essensys-hub/essensys-board-SC941C/docs/schematics.md

# 📐 Schéma Électronique Complet

Vous pouvez consulter ici l'intégralité du schéma électronique du module SC941C.

[📥 Télécharger le PDF complet](assets/SC941C_Schematic.pdf)

## Navigateur de Pages

### Page 1 : Sommaire / Page de Garde
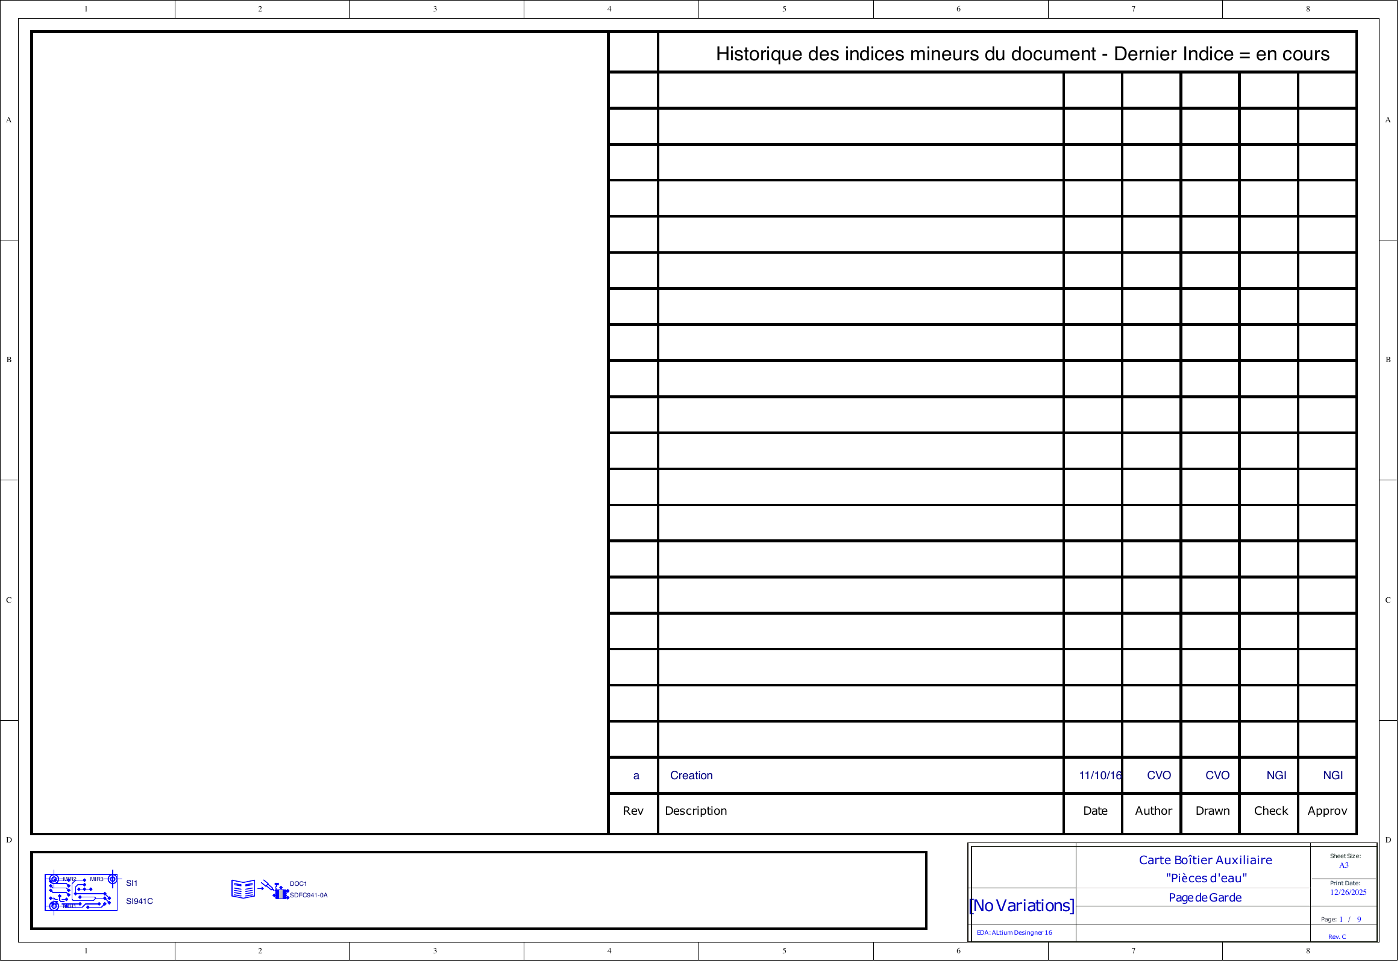
[picture p1: docs/assets/images/schematic_page-1.png]
Page 1


### Page 2 : Microcontrôleur (MCU)
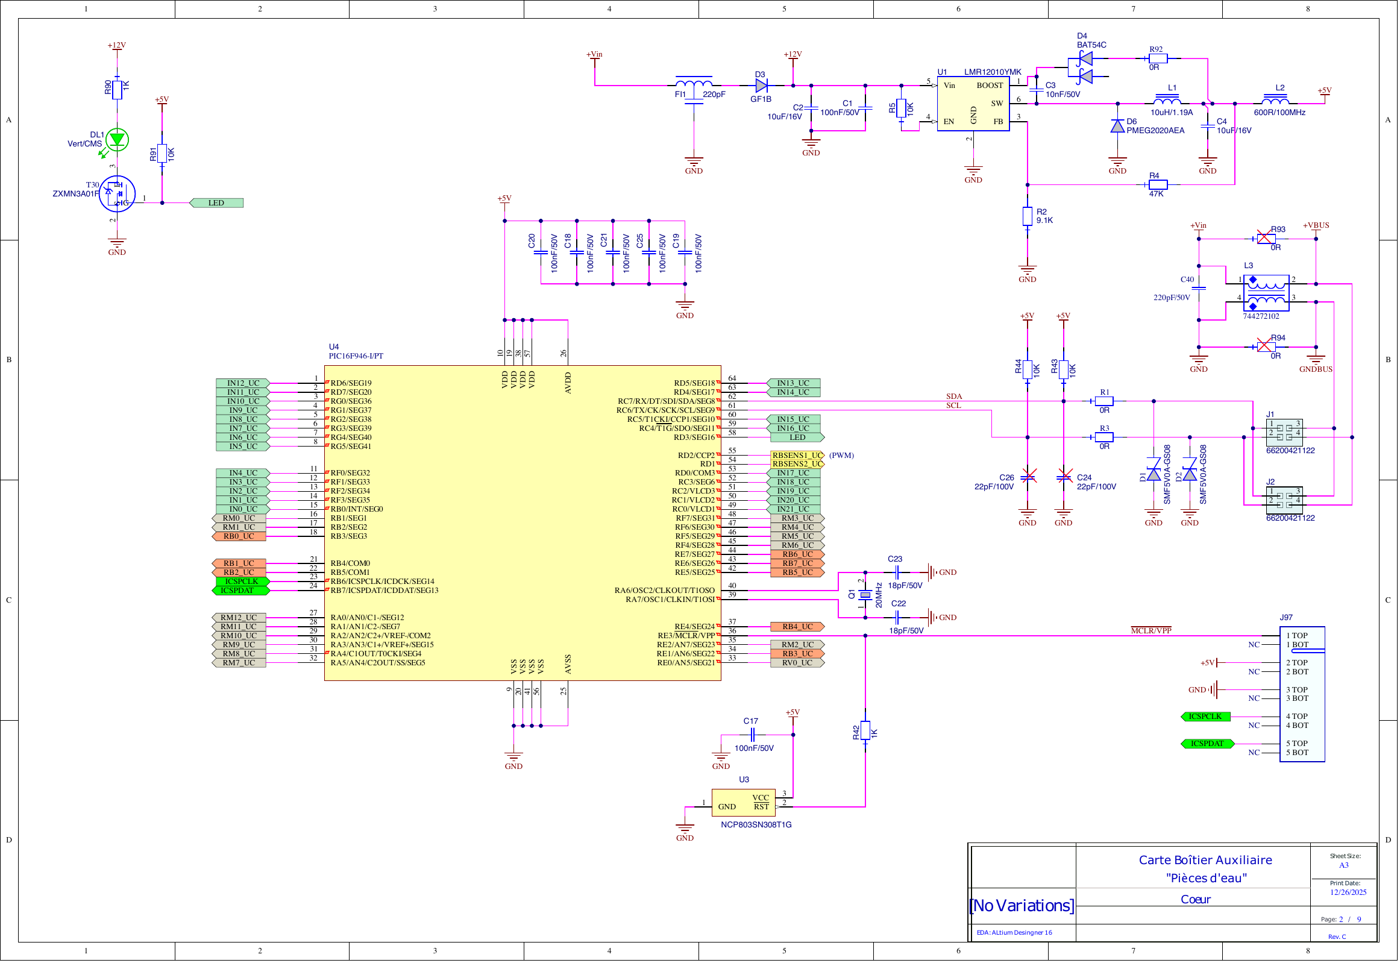
[picture p2: docs/assets/images/schematic_page-2.png]
Page 2


### Page 3 : Alimentation
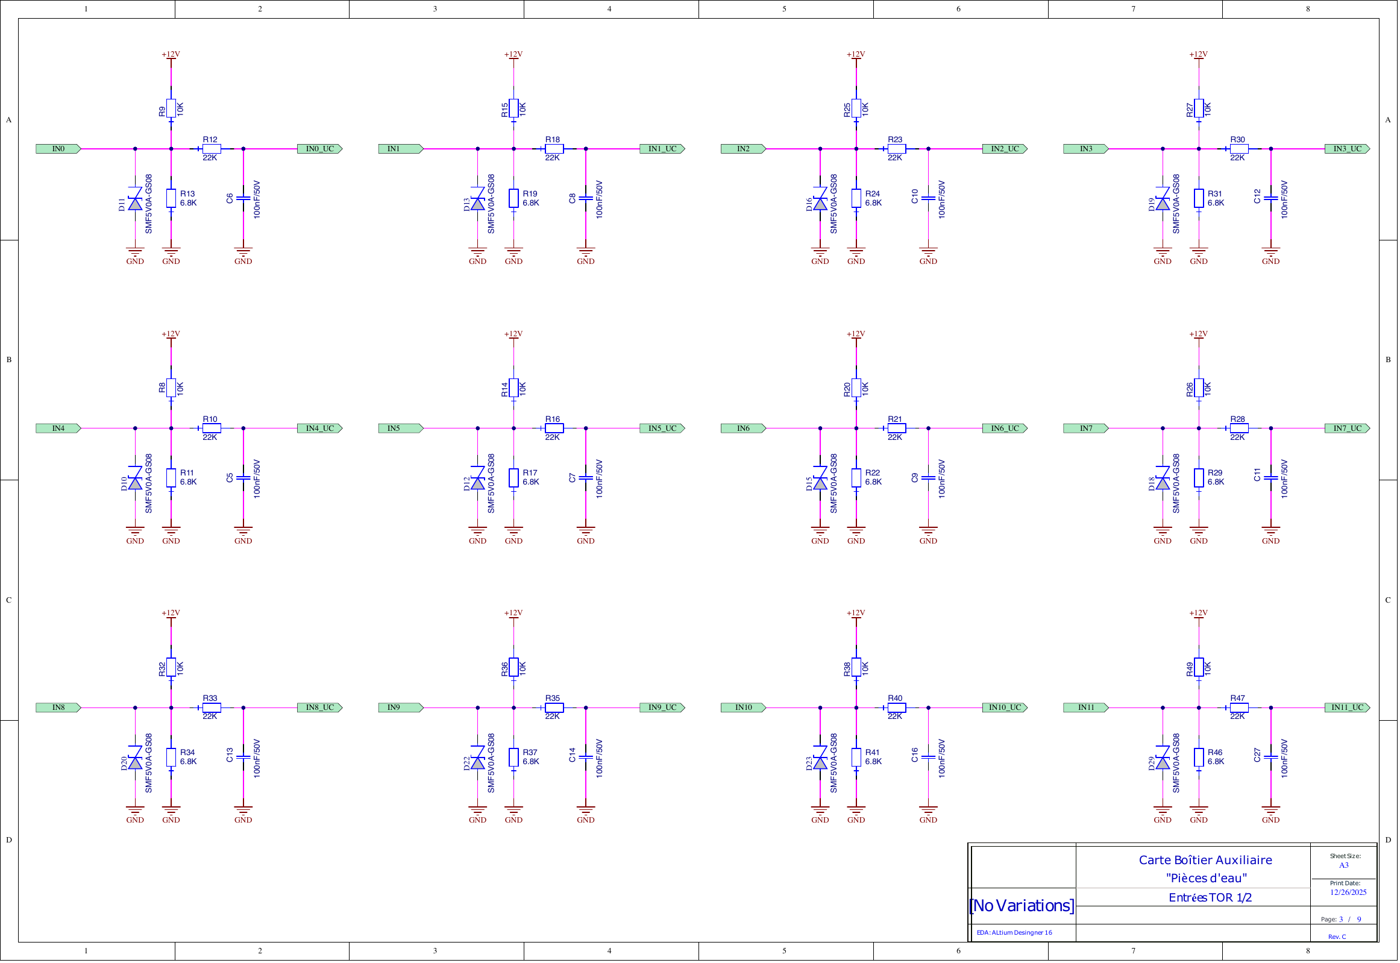
[picture p3: docs/assets/images/schematic_page-3.png]
Page 3


### Page 4 : Interfaces Entrées
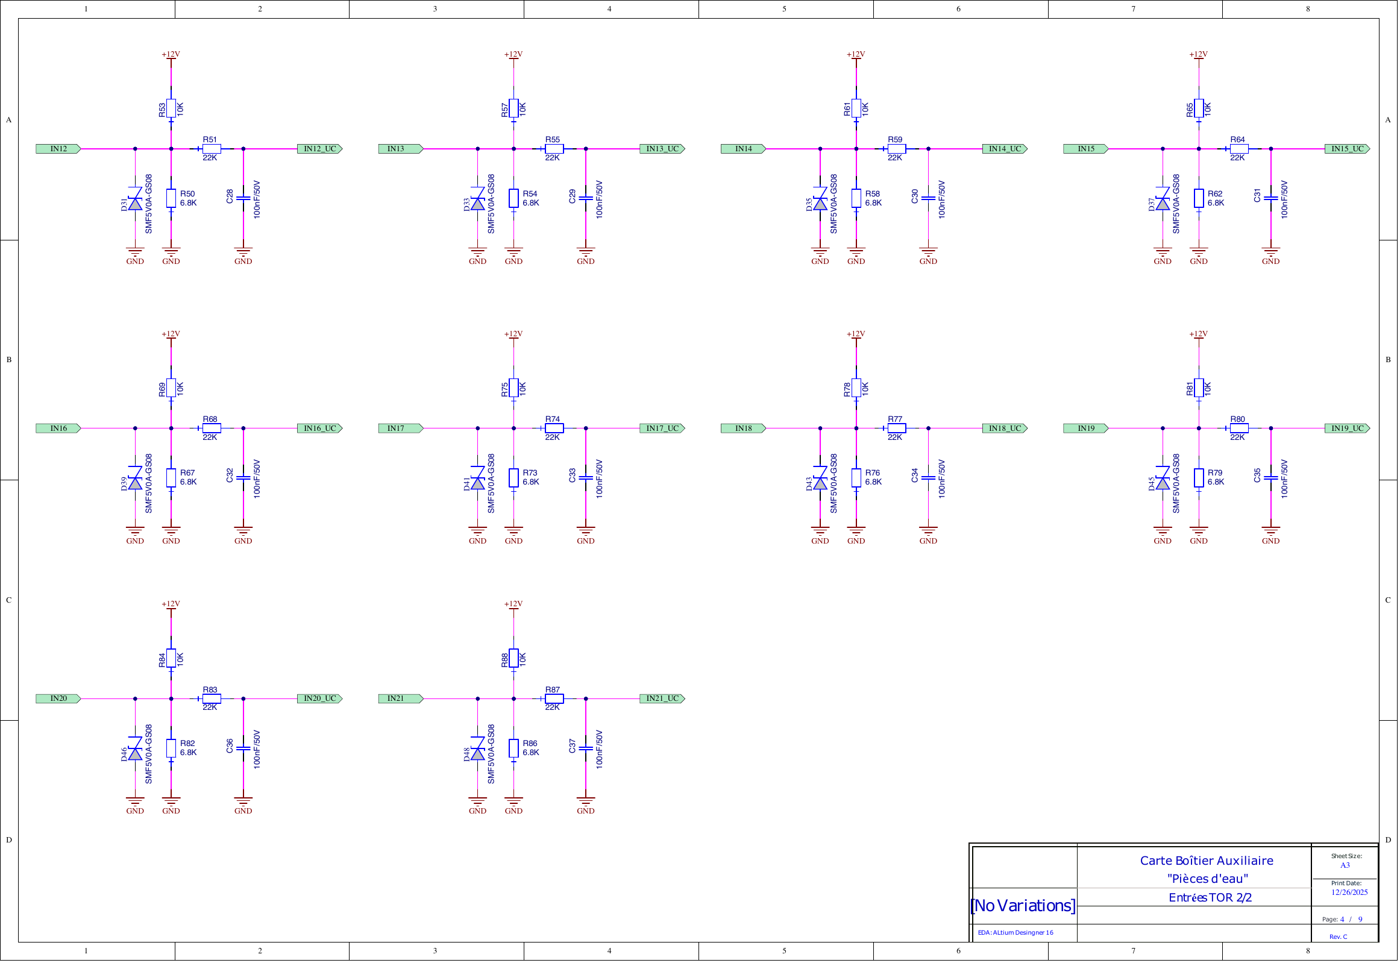
[picture p4: docs/assets/images/schematic_page-4.png]
Page 4


### Page 5 : Interfaces Sorties (Relais)
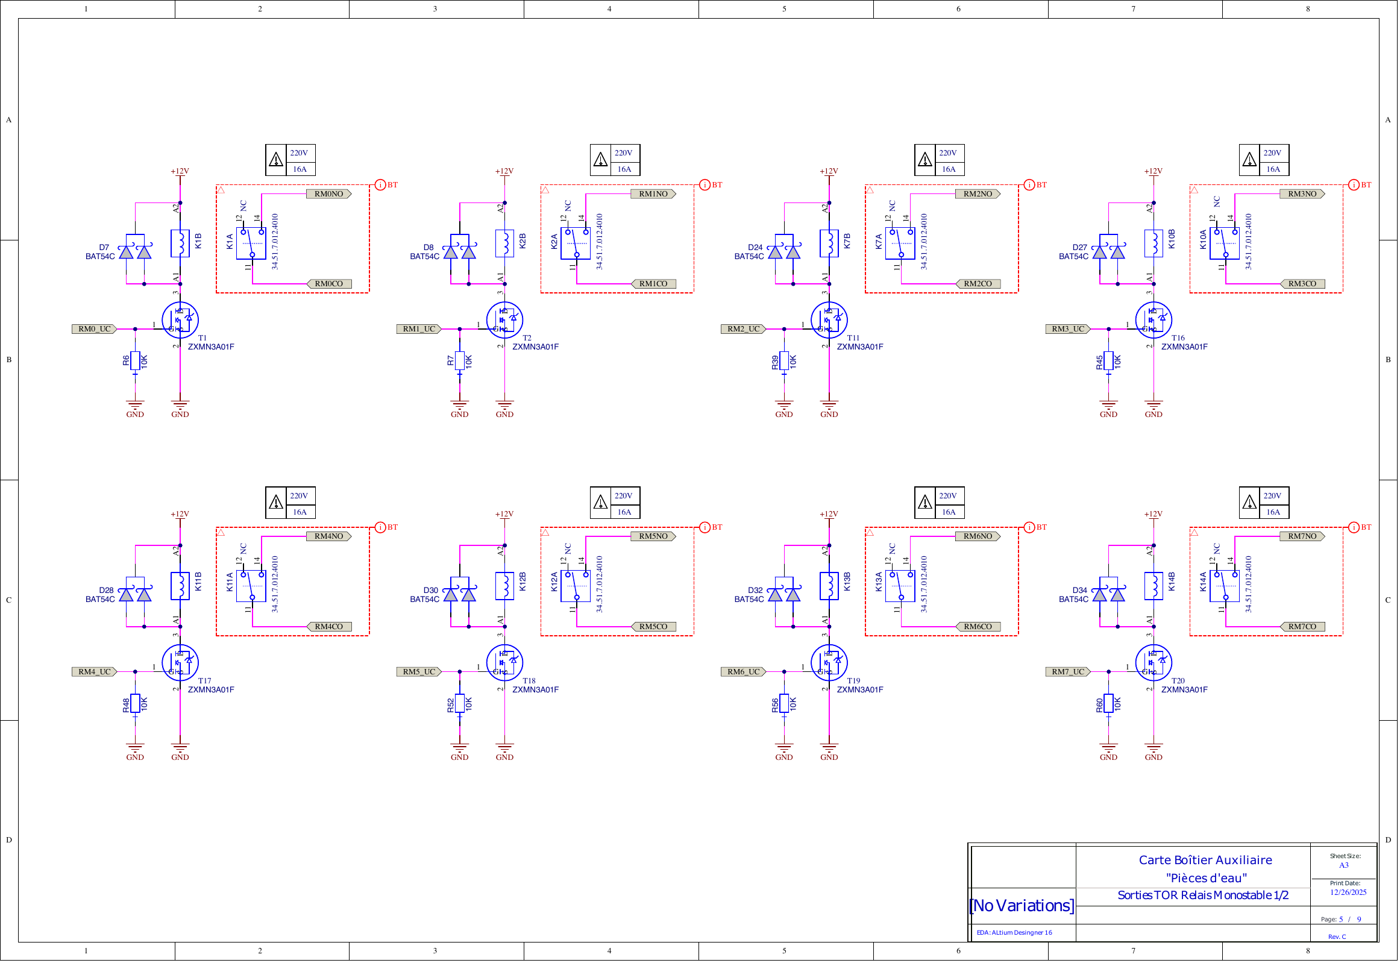
[picture p5: docs/assets/images/schematic_page-5.png]
Page 5


### Page 6 : Variateurs (Triacs)
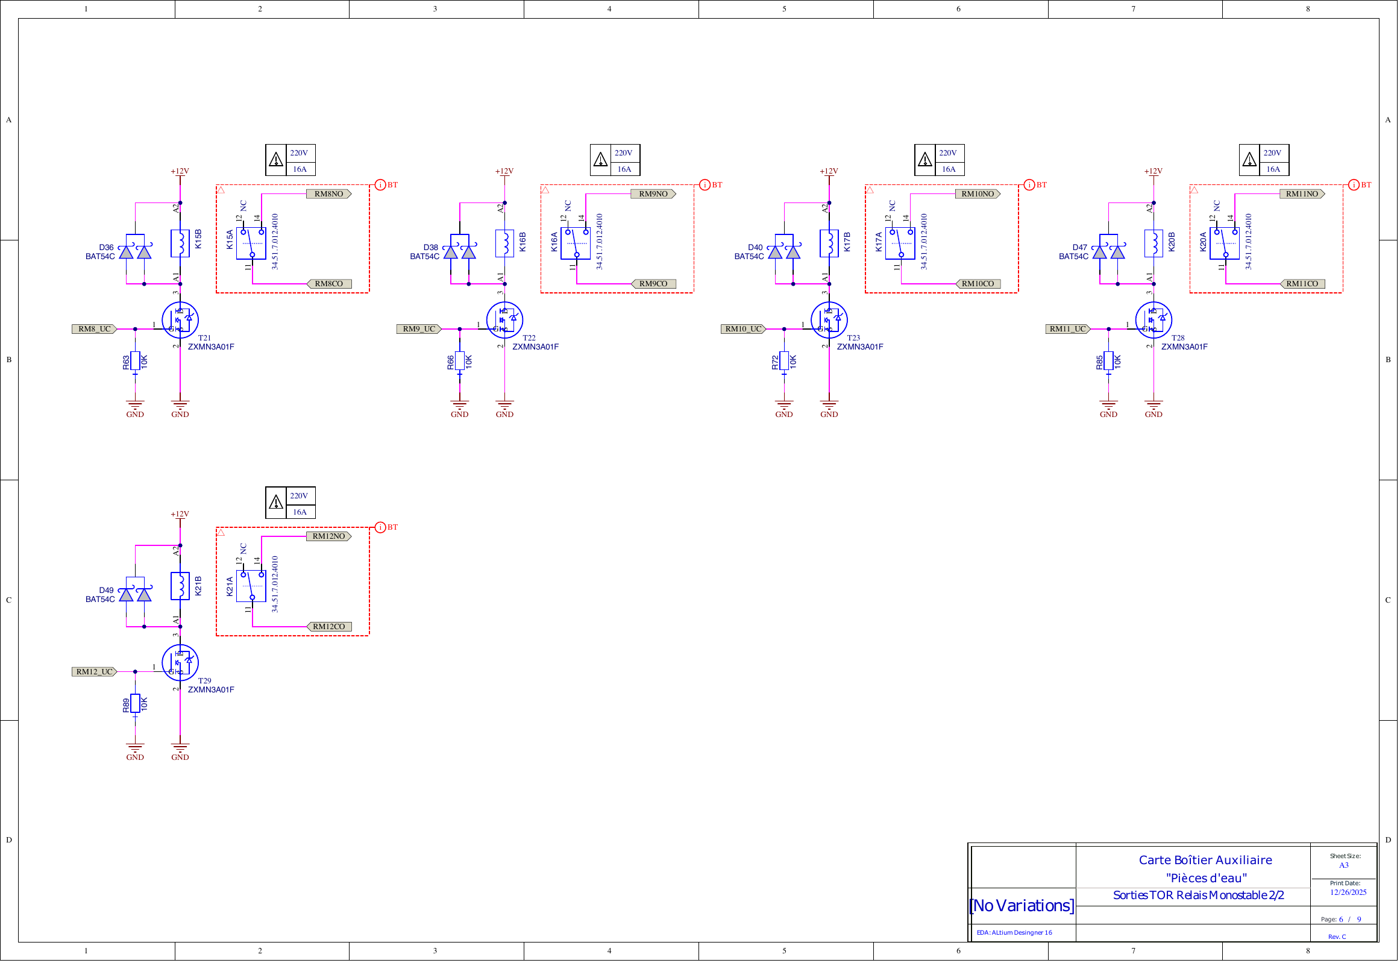
[picture p6: docs/assets/images/schematic_page-6.png]
Page 6


### Page 7 : Bus de Communication
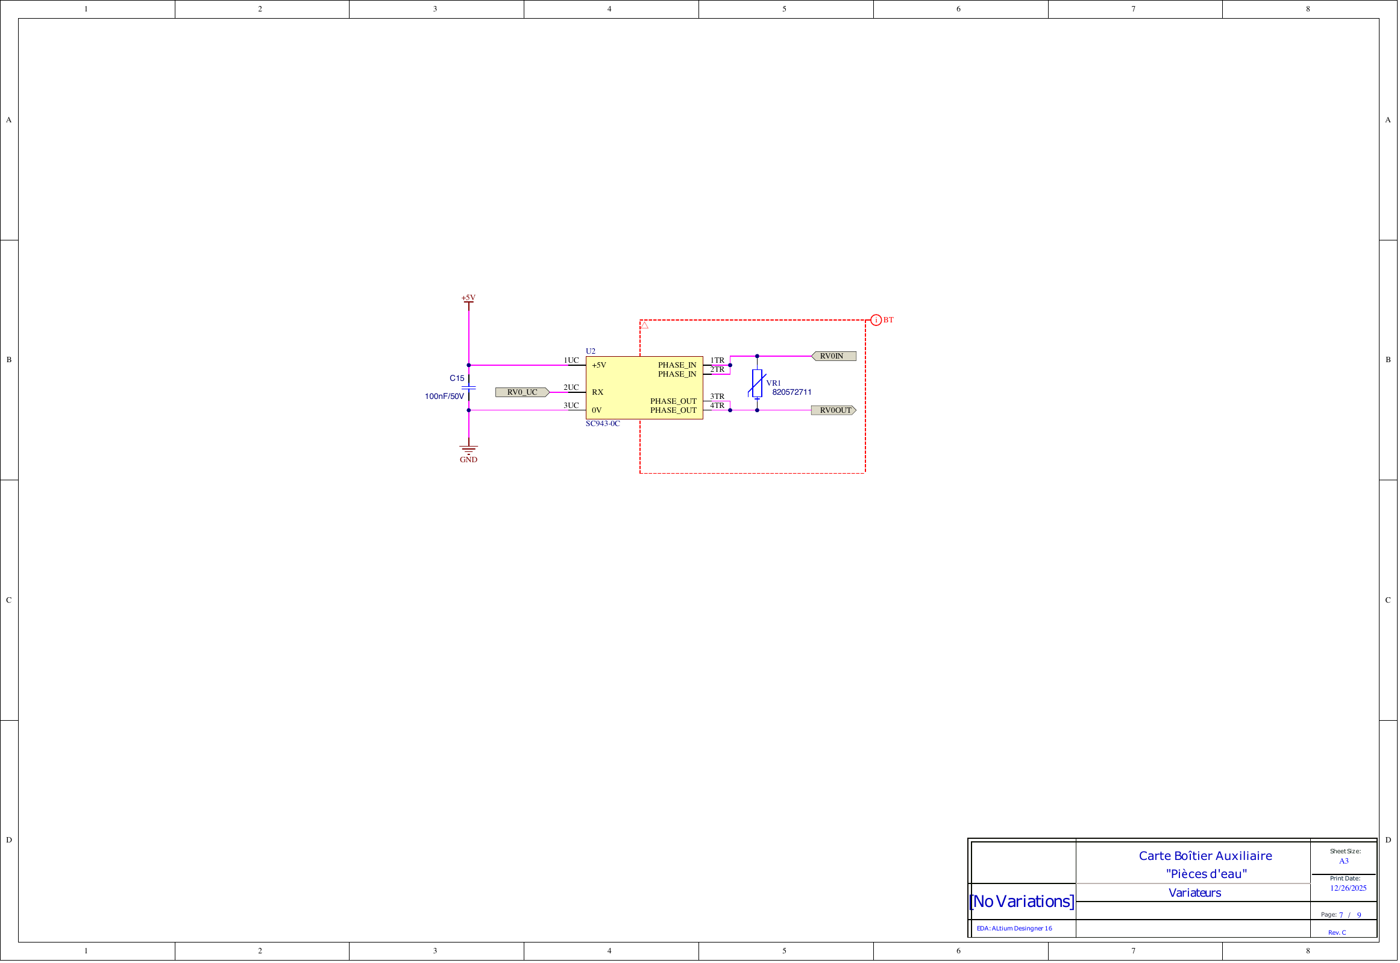
[picture p7: docs/assets/images/schematic_page-7.png]
Page 7


### Page 8 : Connecteurs
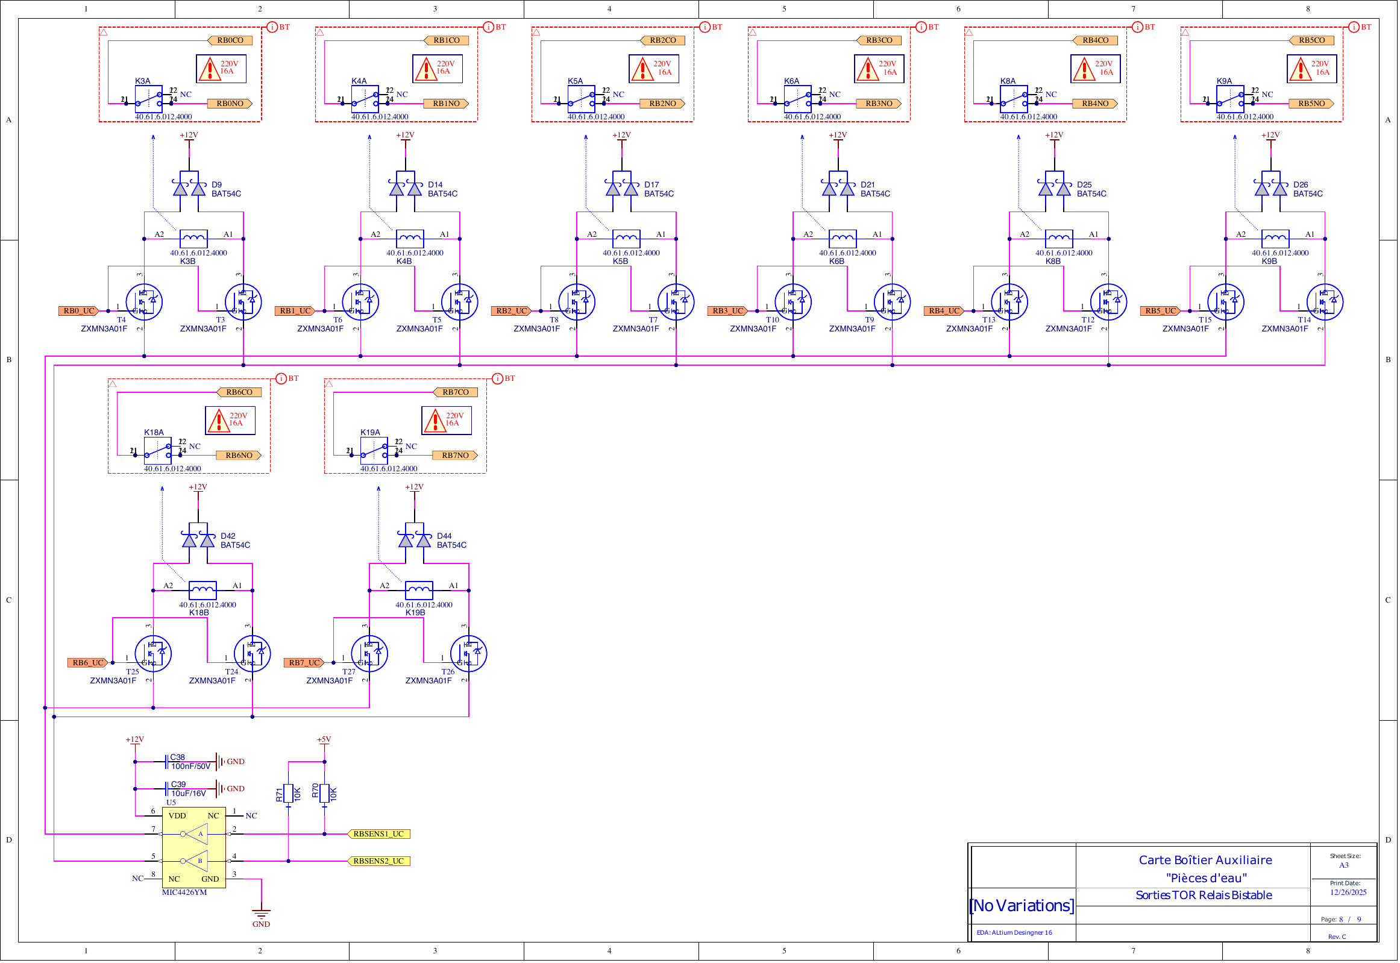
[picture p8: docs/assets/images/schematic_page-8.png]
Page 8


### Page 9 : Mécanique / PCB
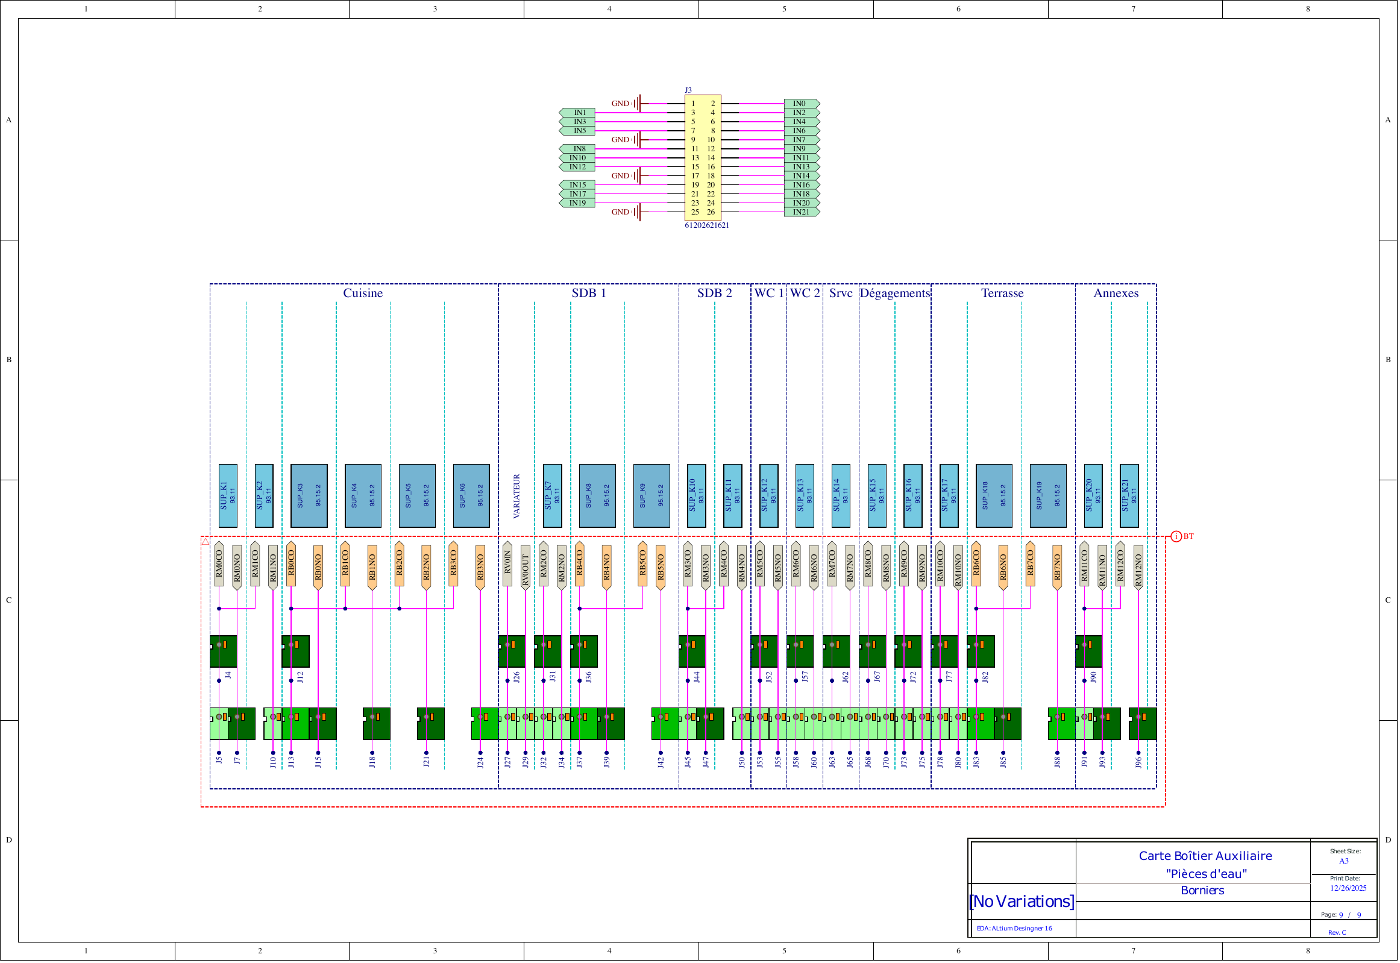
[picture p9: docs/assets/images/schematic_page-9.png]
Page 9
