essensys-hub/essensys-board-SC941C/docs/downloads.md

# 💾 Téléchargements

Vous trouverez ci-dessous les fichiers essentiels pour ce module.

| Fichier | Description | Format | Lien |
| :--- | :--- | :--- | :--- |
| **Schéma Électronique** | Le schéma complet du module | PDF | [📂 Télécharger](assets/SC941C_Schematic.pdf) |
| **Modèle 3D** | Modèle mécanique pour intégration | STEP | [📦 Télécharger](assets/models/SC941C.step) |
| **Manufacturing** | Fichiers de fabrication (Gerbers, Drill) | ZIP | [🏭 Télécharger](assets/manufacturing/SC941C_Gerbers.zip) |
| **Assembly Drawings** | Plans d'assemblage | PDF | [📄 Télécharger](assets/pdfs/Assembly%20Drawings.pdf) |
