essensys-hub/essensys-board-SC941C/SC941C/_DM/DM2/DM2.docx

DM2

L'ajout de la self de mode commun Würth 744272102 pose des problèmes de référence 0V et la communication n'est plus reconnue.

On supprime la self Würth 744272102 L3 et la capa 220pF C40 qui n'a plus de sens non plus.

On soude à la place les 2 résistances 0 Ohm 0805, R93 et R94 prévue pour shunter la self.

Sur la génération actuelle :

Correction à la main sur le schéma.

Correction à la main en nomenclature.

Sur la prochaine génération :

A voir.
