essensys-hub/essensys-board-SC941C/docs/architecture.md

# 🏛️ Architecture

Cette section décrit l'architecture globale du module SC941C et son intégration dans le système Essensys Atrium.

## Diagramme fonctionnel

[Insérer diagramme ici]

## Description des blocs

*   Description bloc 1
*   Description bloc 2
