essensys-hub/essensys-board-SC941C/docs/hardware.md

# 🔌 Hardware

Cette section détaillera les spécifications hardware du module SC941C.

## Spécifications Techniques

*   **MCU** : [À compléter]
*   **Dimensions** : [À compléter]
*   **Alimentation** : [À compléter]

## Composants Clés

*   [Liste des composants principaux]
