essensys-hub/essensys-board-SC941C/SC941C/_DM/DM1/DM1.docx

DM1

Le niveau 0 sur les pattes de uC IN19_UC et IN20_UC sont trop haut (> 0,6V assurant un niveau logique 0). C'était visiblement le cas sur la génération précédente car corrigé par des changements de valeurs de résistances. Mais celà a été non tracé, donc non prix en compte lors de la dernière reprise.

On remplace R80 et R83 par 2k2 à la place de la 22k actuelle.

=> IN19_UC = 206mV au 0 logique.

=> IN20_UC = 57mV au 0 logique.

Sur la génération actuelle :

Correction à la main sur le schéma.

Correction à la main en nomenclature.

Sur la prochaine génération :

Correction du chéma en CAO.
