essensys-hub/essensys-board-SC941C/(list of files, cad)

Other CAD files:
SC941C/3D/SC941C/STEP-744272102-rev1_RGB8421504.sldasm
SC941C/3D/SC941C/J18.sldasm
SC941C/3D/SC941C/J47.sldasm
SC941C/3D/SC941C/R2.sldasm
SC941C/3D/SC941C/J85.sldasm
SC941C/3D/SC941C/T4.sldasm
SC941C/3D/SC941C/J88.sldasm
SC941C/3D/SC941C/J24.sldasm
SC941C/3D/SC941C/T22.sldasm
SC941C/3D/SC941C/U2.sldasm
SC941C/3D/SC941C/R89.sldasm
SC941C/3D/SC941C/C15.sldasm
SC941C/3D/SC941C/D49.sldasm
SC941C/3D/SC941C/C5_1.sldasm
SC941C/3D/SC941C/T27.sldasm
SC941C/3D/SC941C/T18.sldasm
SC941C/3D/SC941C/D26.sldasm
SC941C/3D/SC941C/C10.sldasm
SC941C/3D/SC941C/C14.sldasm
SC941C/3D/SC941C/D18.sldasm
SC941C/3D/SC941C/R67.sldasm
SC941C/3D/SC941C/R57.sldasm
SC941C/3D/SC941C/C12.sldasm
SC941C/3D/SC941C/R48.sldasm
SC941C/3D/SC941C/T12.sldasm
SC941C/3D/SC941C/R69.sldasm
SC941C/3D/SC941C/K5.sldasm
SC941C/3D/SC941C/C7_1.sldasm
SC941C/3D/SC941C/T29.sldasm
SC941C/3D/SC941C/C24.sldasm
SC941C/3D/SC941C/J42.sldasm
SC941C/3D/SC941C/D45.sldasm
SC941C/3D/SC941C/Q1.sldasm
SC941C/3D/SC941C/D25.sldasm
SC941C/3D/SC941C/J29.sldasm
SC941C/3D/SC941C/R73.sldasm
SC941C/3D/SC941C/K17.sldasm
SC941C/3D/SC941C/R55.sldasm
SC941C/3D/SC941C/K1.sldasm
SC941C/3D/SC941C/D33.sldasm
SC941C/3D/SC941C/C7.sldasm
SC941C/3D/SC941C/DL1.sldasm
SC941C/3D/SC941C/K3.sldasm
SC941C/3D/SC941C/K15.sldasm
SC941C/3D/SC941C/J73.sldasm
SC941C/3D/SC941C/J58.sldasm
SC941C/3D/SC941C/C17.sldasm
SC941C/3D/SC941C/R17.sldasm
SC941C/3D/SC941C/D6.sldasm
SC941C/3D/SC941C/R18.sldasm
SC941C/3D/SC941C/K13.sldasm
SC941C/3D/SC941C/T9.sldasm
SC941C/3D/SC941C/K8.sldasm
SC941C/3D/SC941C/R52.sldasm
SC941C/3D/SC941C/J5.sldasm
SC941C/3D/SC941C/J93.sldasm
SC941C/3D/SC941C/D29.sldasm
SC941C/3D/SC941C/R74.sldasm
SC941C/3D/SC941C/J2.sldasm
SC941C/3D/SC941C/C4.sldasm
SC941C/3D/SC941C/R38.sldasm
SC941C/3D/SC941C/J67.sldasm
SC941C/3D/SC941C/C9_1.sldasm
SC941C/3D/SC941C/R19.sldasm
SC941C/3D/SC941C/D19.sldasm
SC941C/3D/SC941C/SUP_K18.sldasm
SC941C/3D/SC941C/T25.sldasm
SC941C/3D/SC941C/U3.sldasm
SC941C/3D/SC941C/T3.sldasm
SC941C/3D/SC941C/K20.sldasm
SC941C/3D/SC941C/C35.sldasm
SC941C/3D/SC941C/C6.sldasm
SC941C/3D/SC941C/R51.sldasm
SC941C/3D/SC941C/R45.sldasm
SC941C/3D/SC941C/R34.sldasm
SC941C/3D/SC941C/C37.sldasm
SC941C/3D/SC941C/R16.sldasm
SC941C/3D/SC941C/T10.sldasm
SC941C/3D/SC941C/J15.sldasm
SC941C/3D/SC941C/J90.sldasm
SC941C/3D/SC941C/R65.sldasm
SC941C/3D/SC941C/R93.sldasm
SC941C/3D/SC941C/D10.sldasm
SC941C/3D/SC941C/R36.sldasm
SC941C/3D/SC941C/D32.sldasm
SC941C/3D/SC941C/R90.sldasm
SC941C/3D/SC941C/C4_1.sldasm
SC941C/3D/SC941C/C39.sldasm
SC941C/3D/SC941C/R81.sldasm
SC941C/3D/SC941C/R94.sldasm
SC941C/3D/SC941C/SUP_K6.sldasm
SC941C/3D/SC941C/R32.sldasm
SC941C/3D/SC941C/J1.sldasm
SC941C/3D/SC941C/J70.sldasm
SC941C/3D/SC941C/K16.sldasm
SC941C/3D/SC941C/R61.sldasm
SC941C/3D/SC941C/C13.sldasm
SC941C/3D/SC941C/J50.sldasm
SC941C/3D/SC941C/SUP_K4.sldasm
SC941C/3D/SC941C/D47.sldasm
SC941C/3D/SC941C/T17.sldasm
SC941C/3D/SC941C/J82.sldasm
SC941C/3D/SC941C/T19.sldasm
SC941C/3D/SC941C/D13.sldasm
SC941C/3D/SC941C/D42.sldasm
SC941C/3D/SC941C/R9.sldasm
SC941C/3D/SC941C/T28.sldasm
SC941C/3D/SC941C/L1.sldasm
SC941C/3D/SC941C/R26_1.sldasm
SC941C/3D/SC941C/D7.sldasm
SC941C/3D/SC941C/D16.sldasm
SC941C/3D/SC941C/WE-TPC_4828.sldasm
SC941C/3D/SC941C/User_Library-SOIC-8-150_1.sldasm
SC941C/3D/SC941C/K6.sldasm
SC941C/3D/SC941C/C20.sldasm
SC941C/3D/SC941C/T13.sldasm
SC941C/3D/SC941C/D3.sldasm
SC941C/3D/SC941C/T5.sldasm
SC941C/3D/SC941C/R77.sldasm
SC941C/3D/SC941C/SUP_K9.sldasm
SC941C/3D/SC941C/R70.sldasm
SC941C/3D/SC941C/R72.sldasm
SC941C/3D/SC941C/D48.sldasm
SC941C/3D/SC941C/R47.sldasm
SC941C/3D/SC941C/K9.sldasm
SC941C/3D/SC941C/J60.sldasm
SC941C/3D/SC941C/D5.sldasm
SC941C/3D/SC941C/R88.sldasm
SC941C/3D/SC941C/J31.sldasm
SC941C/3D/SC941C/J53.sldasm
SC941C/3D/SC941C/D44.sldasm
SC941C/3D/SC941C/J12.sldasm
SC941C/3D/SC941C/U2_1.sldasm
SC941C/3D/SC941C/J91.sldasm
SC941C/3D/SC941C/T16.sldasm
SC941C/3D/SC941C/D24.sldasm
SC941C/3D/SC941C/C3.sldasm
SC941C/3D/SC941C/R12_1.sldasm
SC941C/3D/SC941C/R71.sldasm
SC941C/3D/SC941C/R64.sldasm
SC941C/3D/SC941C/R41.sldasm
SC941C/3D/SC941C/C2.sldasm
SC941C/3D/SC941C/C6_1.sldasm
SC941C/3D/SC941C/R11.sldasm
SC941C/3D/SC941C/R21.sldasm
SC941C/3D/SC941C/R23.sldasm
SC941C/3D/SC941C/J21.sldasm
SC941C/3D/SC941C/T23.sldasm
SC941C/3D/SC941C/R19_1.sldasm
SC941C/3D/SC941C/T7_1.sldasm
SC941C/3D/SC941C/1151710376.sldasm
SC941C/3D/SC941C/1151710512.sldasm
SC941C/3D/SC941C/1151724792.sldasm
SC941C/3D/SC941C/1151724928.sldasm
SC941C/3D/SC941C/1151725064.sldasm
SC941C/3D/SC941C/1790348.sldasm
SC941C/3D/SC941C/1790377.sldasm
SC941C/3D/SC941C/1790487.sldasm
SC941C/3D/SC941C/61202621621.sldprt
SC941C/3D/SC941C/6120xx21621_PIN.sldprt
SC941C/3D/SC941C/905260416.sldasm
SC941C/3D/SC941C/905260688.sldasm
SC941C/3D/SC941C/905261096.sldasm
SC941C/3D/SC941C/905261368.sldasm
SC941C/3D/SC941C/905261640.sldasm
SC941C/3D/SC941C/905262864.sldasm
SC941C/3D/SC941C/905263816.sldasm
SC941C/3D/SC941C/905265720.sldasm
SC941C/3D/SC941C/905266128.sldasm
SC941C/3D/SC941C/905266264.sldasm
SC941C/3D/SC941C/905266536.sldasm
SC941C/3D/SC941C/905269392.sldasm
SC941C/3D/SC941C/905269800.sldasm
SC941C/3D/SC941C/905275240.sldasm
SC941C/3D/SC941C/Base.sldprt
SC941C/3D/SC941C/Base_1.sldprt
SC941C/3D/SC941C/Base_2.sldprt
SC941C/3D/SC941C/Board.sldprt
SC941C/3D/SC941C/Board_1.sldprt
SC941C/3D/SC941C/C1.sldasm
SC941C/3D/SC941C/C11.sldasm
SC941C/3D/SC941C/C16.sldasm
SC941C/3D/SC941C/C18.sldasm
SC941C/3D/SC941C/C19.sldasm
SC941C/3D/SC941C/C1_1.sldasm
SC941C/3D/SC941C/C21.sldasm
SC941C/3D/SC941C/C22.sldasm
SC941C/3D/SC941C/C23.sldasm
SC941C/3D/SC941C/C25.sldasm
SC941C/3D/SC941C/C26.sldasm
SC941C/3D/SC941C/C27.sldasm
SC941C/3D/SC941C/C28.sldasm
SC941C/3D/SC941C/C29.sldasm
SC941C/3D/SC941C/C2_1.sldasm
SC941C/3D/SC941C/C30.sldasm
SC941C/3D/SC941C/C31.sldasm
SC941C/3D/SC941C/C32.sldasm
SC941C/3D/SC941C/C33.sldasm
SC941C/3D/SC941C/C34.sldasm
SC941C/3D/SC941C/C36.sldasm
SC941C/3D/SC941C/C38.sldasm
SC941C/3D/SC941C/C3_1.sldasm
SC941C/3D/SC941C/C40.sldasm
SC941C/3D/SC941C/C5.sldasm
SC941C/3D/SC941C/C8.sldasm
SC941C/3D/SC941C/C8_1.sldasm
SC941C/3D/SC941C/C9.sldasm
SC941C/3D/SC941C/Contact.sldprt
SC941C/3D/SC941C/D1.sldasm
SC941C/3D/SC941C/D11.sldasm
SC941C/3D/SC941C/D12.sldasm
SC941C/3D/SC941C/D14.sldasm
SC941C/3D/SC941C/D15.sldasm
SC941C/3D/SC941C/D17.sldasm
SC941C/3D/SC941C/D1_1.sldasm
SC941C/3D/SC941C/D2.sldasm
SC941C/3D/SC941C/D20.sldasm
SC941C/3D/SC941C/D21.sldasm
SC941C/3D/SC941C/D22.sldasm
SC941C/3D/SC941C/D23.sldasm
SC941C/3D/SC941C/D27.sldasm
SC941C/3D/SC941C/D28.sldasm
SC941C/3D/SC941C/D2_1.sldasm
SC941C/3D/SC941C/D30.sldasm
SC941C/3D/SC941C/D31.sldasm
SC941C/3D/SC941C/D34.sldasm
SC941C/3D/SC941C/D35.sldasm
SC941C/3D/SC941C/D36.sldasm
SC941C/3D/SC941C/D37.sldasm
SC941C/3D/SC941C/D38.sldasm
SC941C/3D/SC941C/D39.sldasm
SC941C/3D/SC941C/D3_1.sldasm
SC941C/3D/SC941C/D4.sldasm
SC941C/3D/SC941C/D40.sldasm
SC941C/3D/SC941C/D41.sldasm
SC941C/3D/SC941C/D43.sldasm
SC941C/3D/SC941C/D46.sldasm
SC941C/3D/SC941C/D4_1.sldasm
SC941C/3D/SC941C/D6_1.sldasm
SC941C/3D/SC941C/D7_1.sldasm
SC941C/3D/SC941C/D8.sldasm
SC941C/3D/SC941C/D9.sldasm
SC941C/3D/SC941C/Extruded.sldprt
SC941C/3D/SC941C/Extruded_1.sldprt
SC941C/3D/SC941C/Extruded_10.sldprt
SC941C/3D/SC941C/Extruded_11.sldprt
SC941C/3D/SC941C/Extruded_12.sldprt
SC941C/3D/SC941C/Extruded_13.sldprt
SC941C/3D/SC941C/Extruded_14.sldprt
SC941C/3D/SC941C/Extruded_15.sldprt
SC941C/3D/SC941C/Extruded_16.sldprt
SC941C/3D/SC941C/Extruded_17.sldprt
SC941C/3D/SC941C/Extruded_18.sldprt
SC941C/3D/SC941C/Extruded_2.sldprt
SC941C/3D/SC941C/Extruded_3.sldprt
SC941C/3D/SC941C/Extruded_4.sldprt
SC941C/3D/SC941C/Extruded_5.sldprt
SC941C/3D/SC941C/Extruded_6.sldprt
SC941C/3D/SC941C/Extruded_7.sldprt
SC941C/3D/SC941C/Extruded_8.sldprt
SC941C/3D/SC941C/Extruded_9.sldprt
SC941C/3D/SC941C/J10.sldasm
SC941C/3D/SC941C/J13.sldasm
SC941C/3D/SC941C/J26.sldasm
SC941C/3D/SC941C/J27.sldasm
SC941C/3D/SC941C/J3.sldasm
SC941C/3D/SC941C/J32.sldasm
SC941C/3D/SC941C/J34.sldasm
SC941C/3D/SC941C/J36.sldasm
SC941C/3D/SC941C/J37.sldasm
SC941C/3D/SC941C/J39.sldasm
SC941C/3D/SC941C/J4.sldasm
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
