essensys-hub/essensys-board-SC941C/docs/assets/SC941C_Schematic.pdf

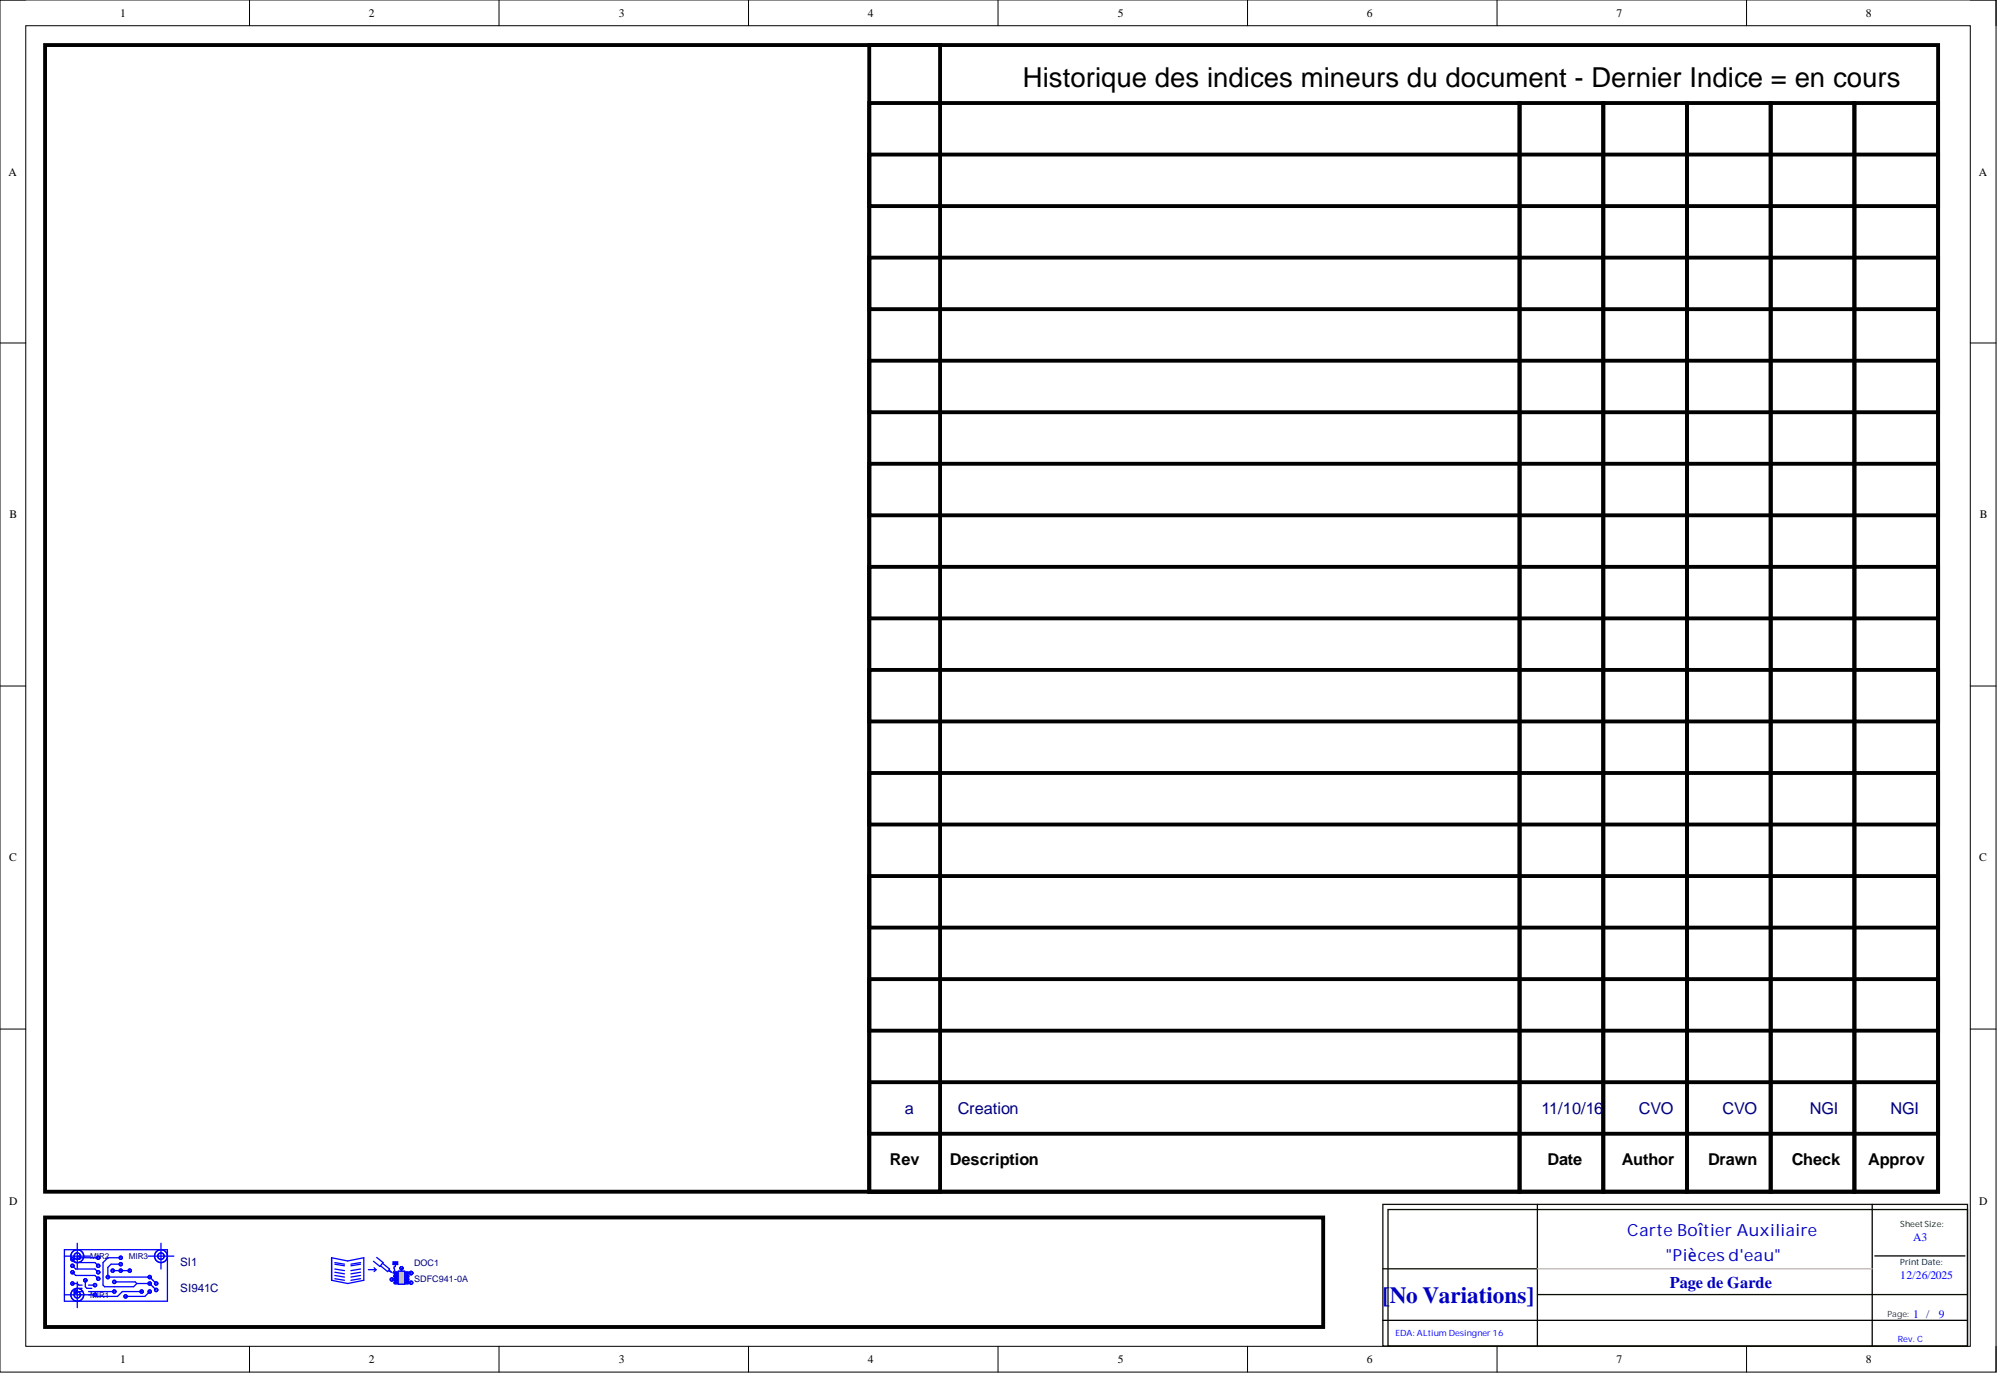
[picture p10: page 1]
t Date:

Historique des indices mineurs du document - Dernier Indice = en cours

a | Creat i o n | 11/10/ 1 6 | C V O | C V O | N G I | N G I

Rev | Descripti o n | Dat e | Autho r | Draw n | Check | Approv

[No Variations] | Page de Garde

Pag e : /

EDA: AL t i u m Des i n g ner | | Rev . C

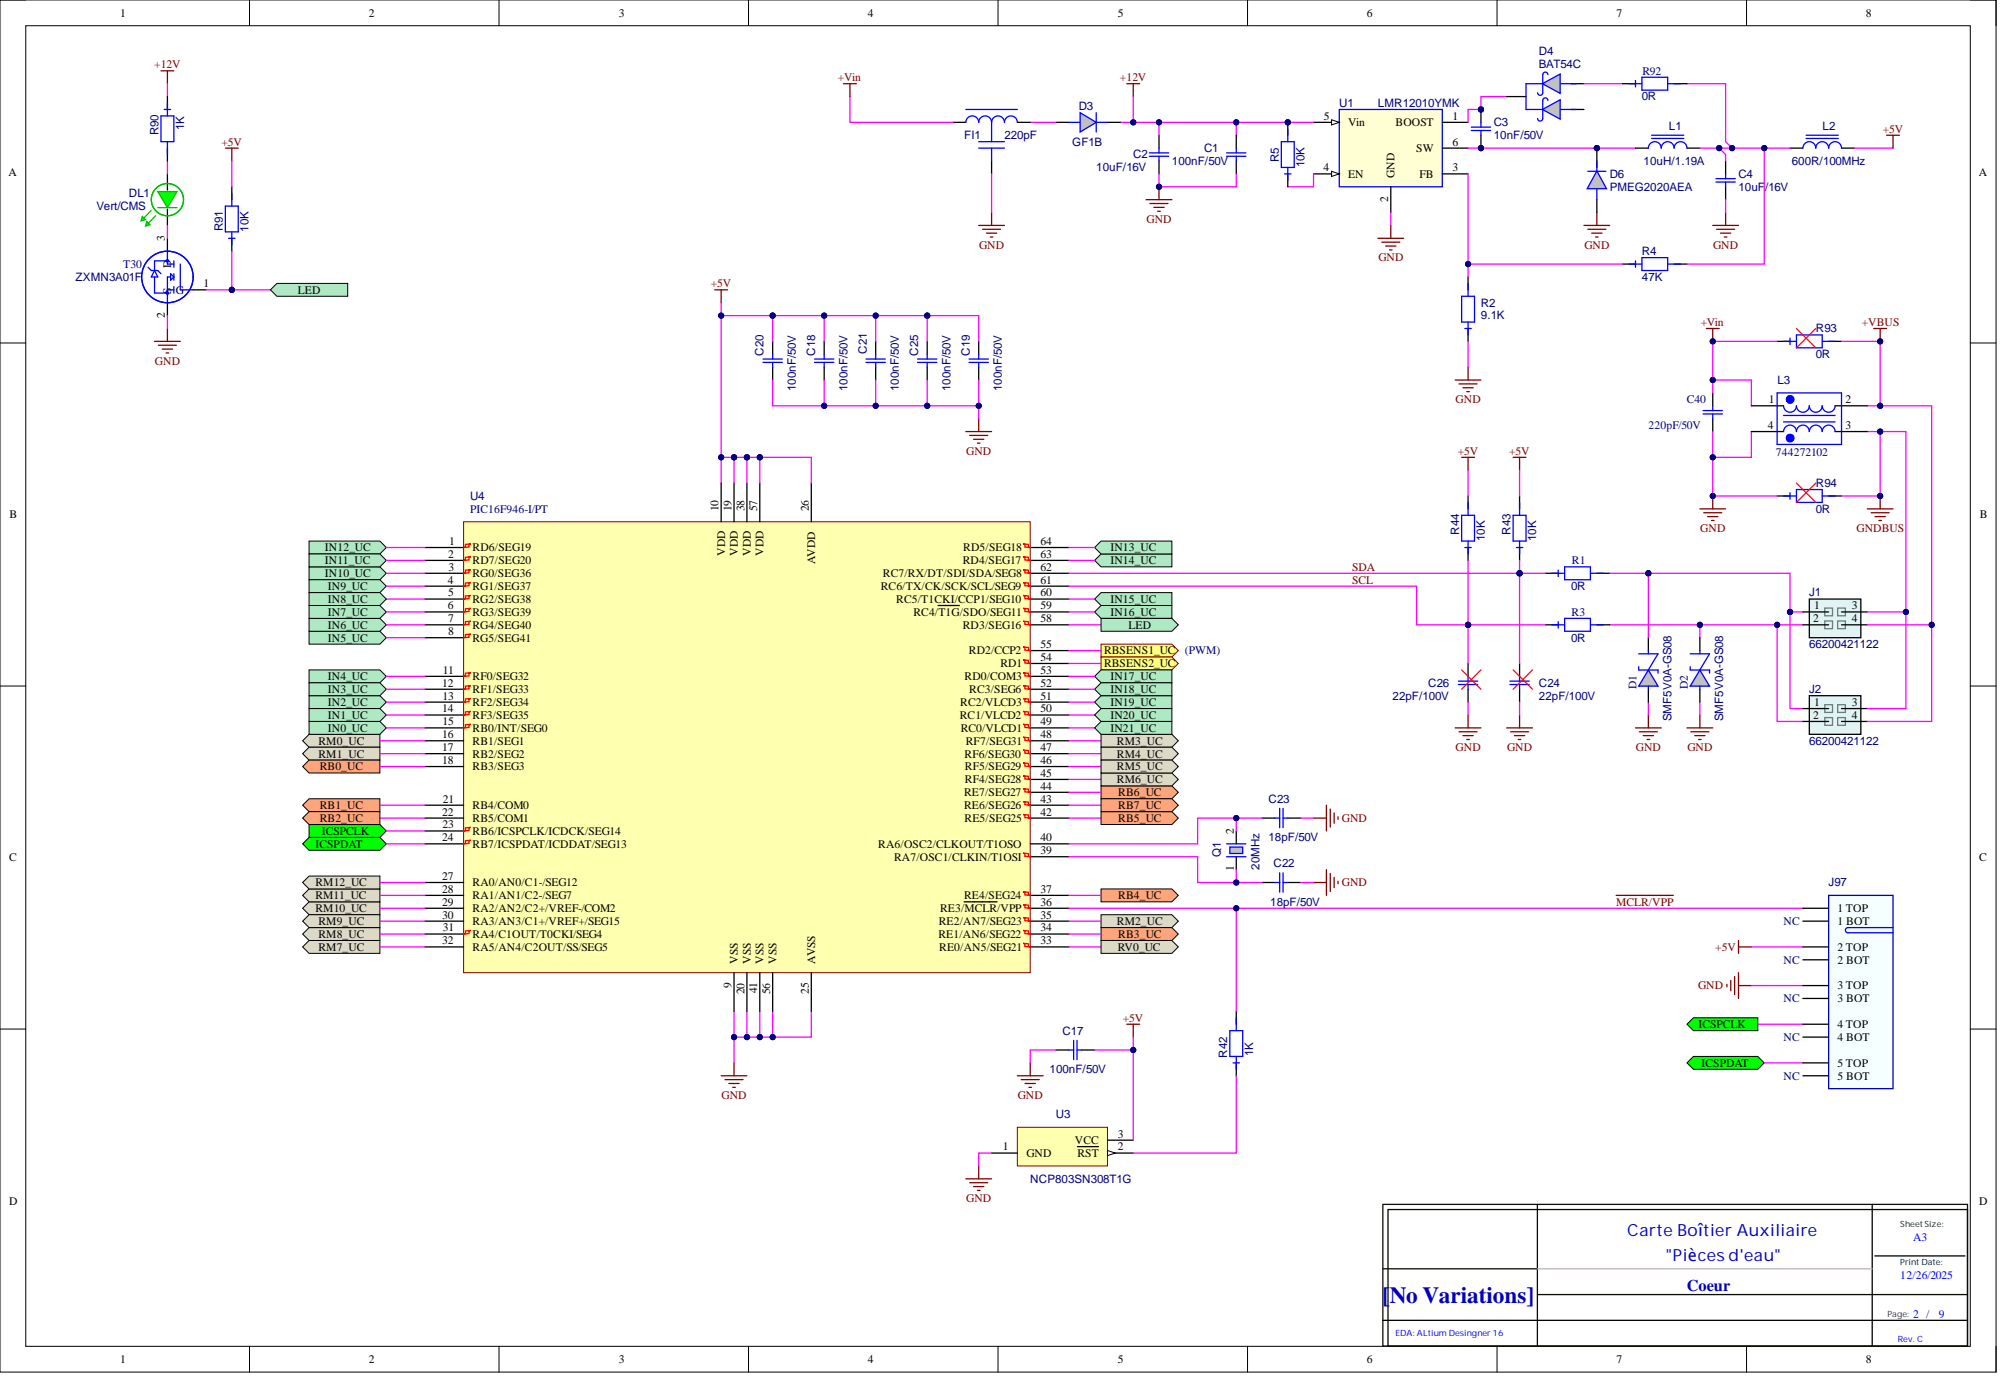
[picture p11: page 2]

SCL

Coeur

Pag e : /

EDA: AL t i u m Des i n g ner | | Rev . C

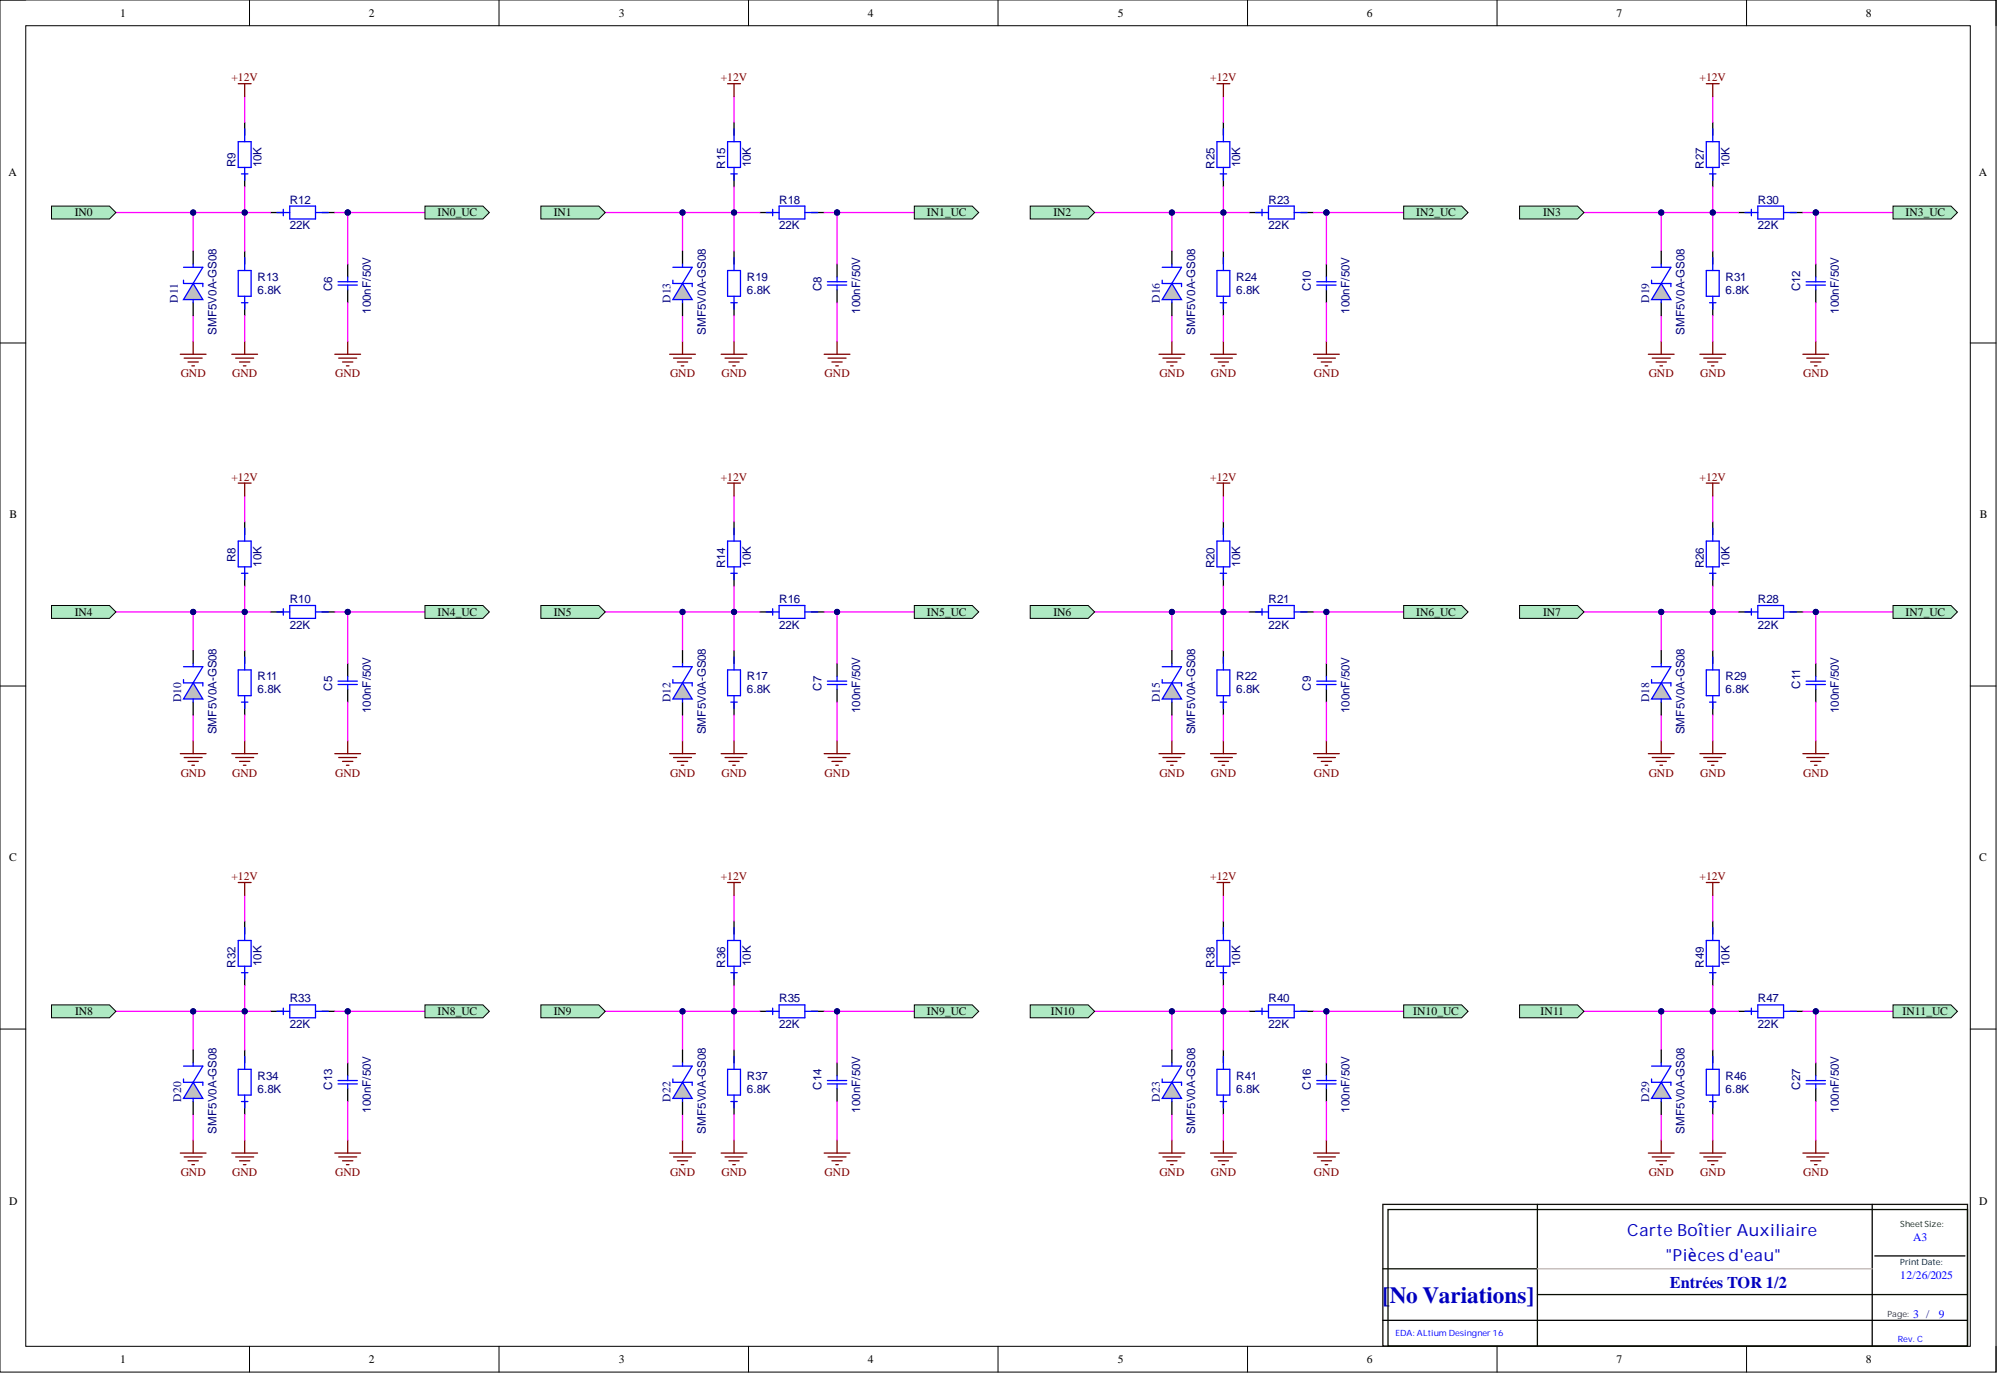
[picture p12: page 3]

Page:

EDA: ALtium Desingner 16 | | Rev. C

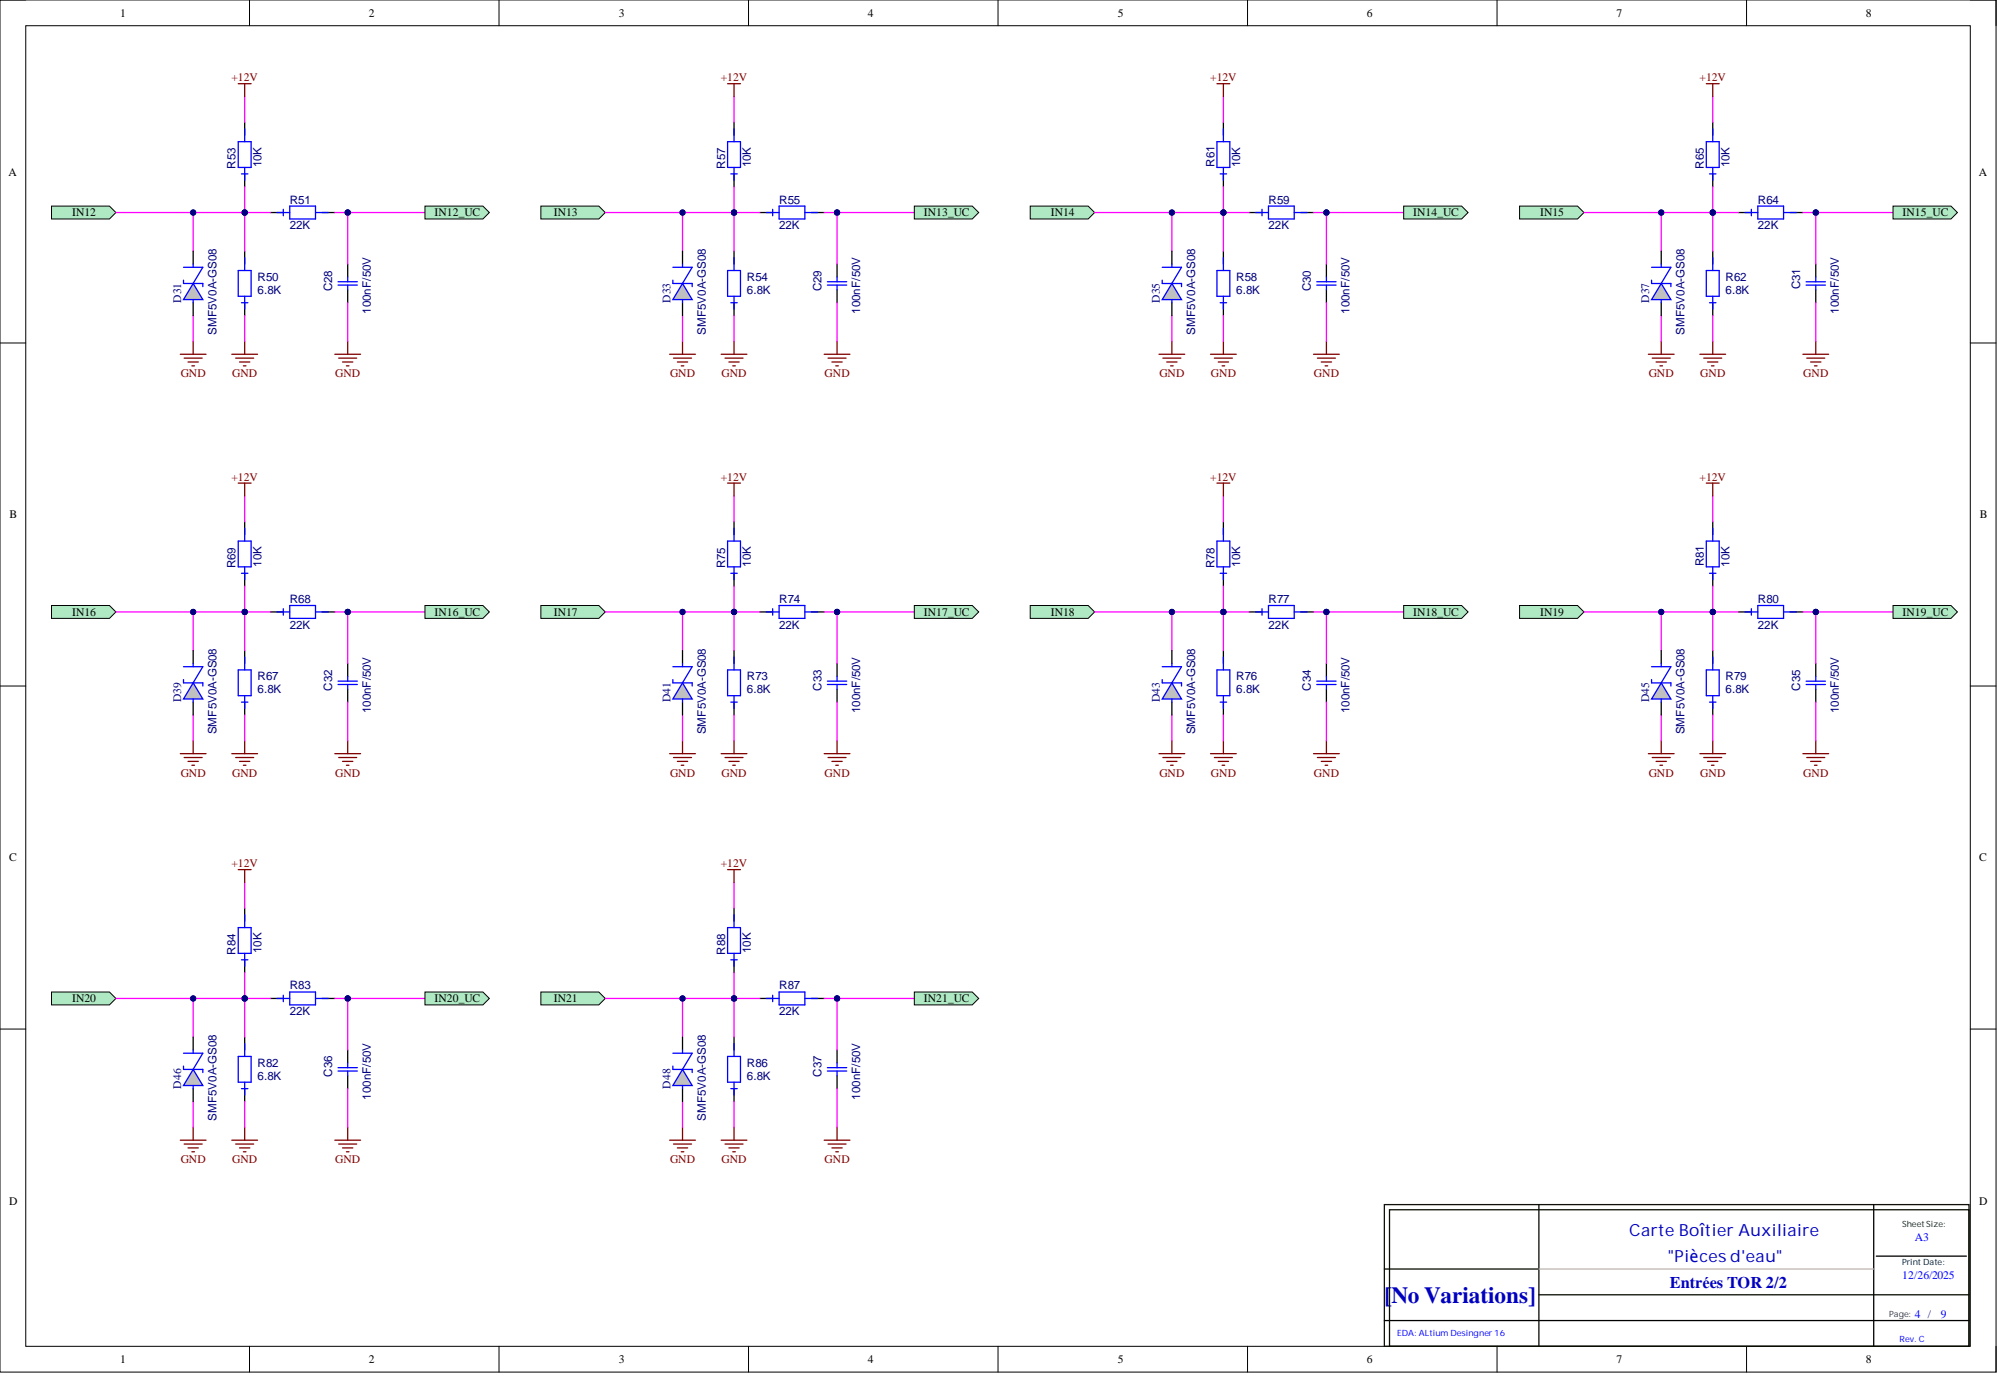
[picture p13: page 4]

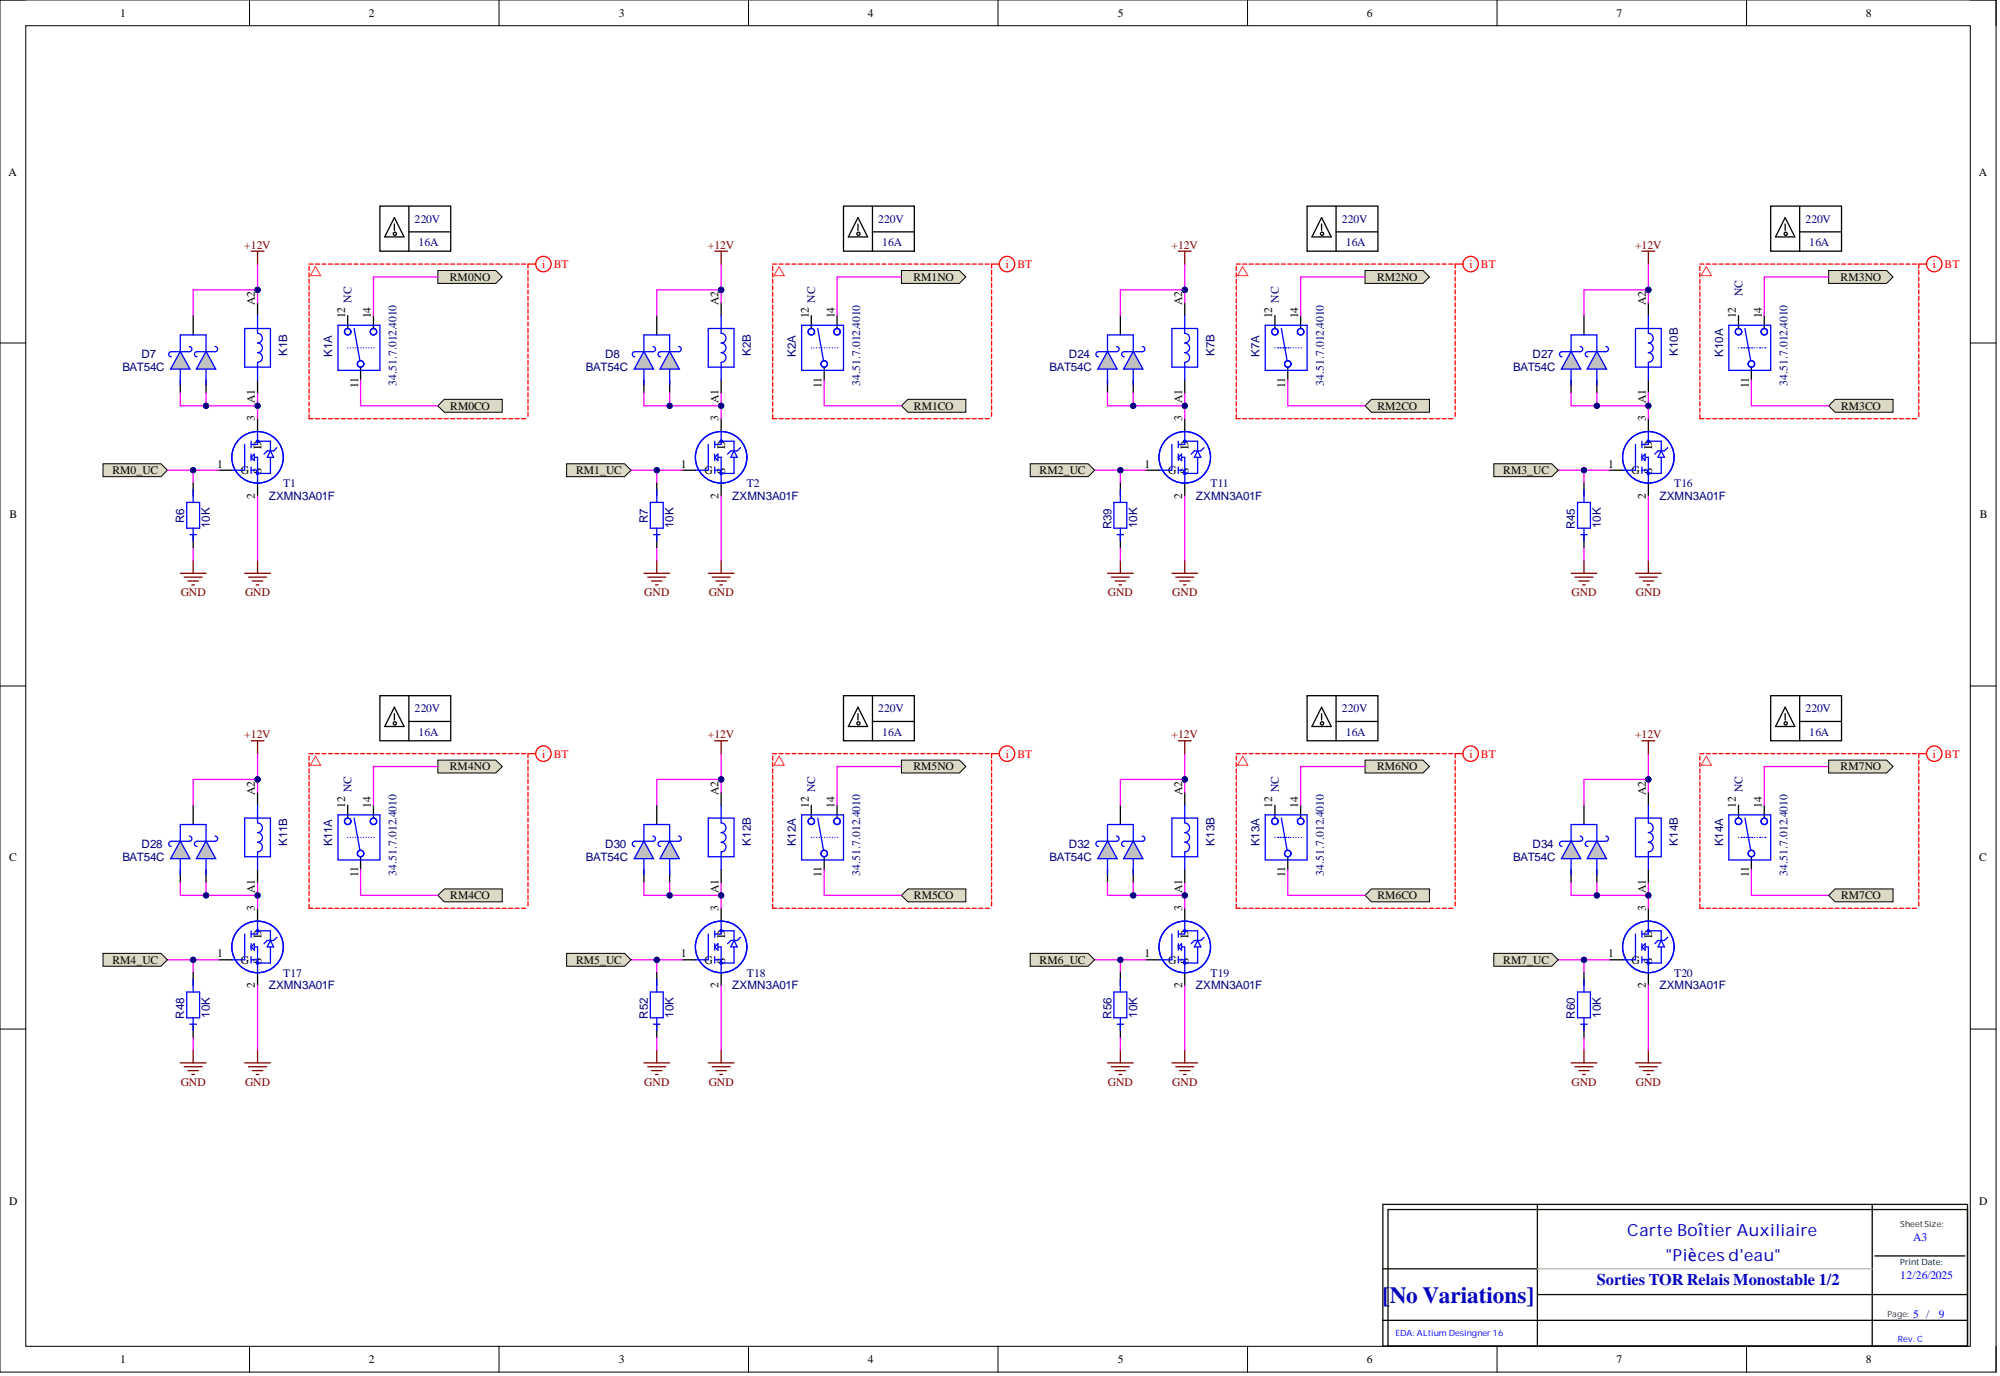
[picture p14: page 5]

Sorties TOR Relais Monostable 1/2

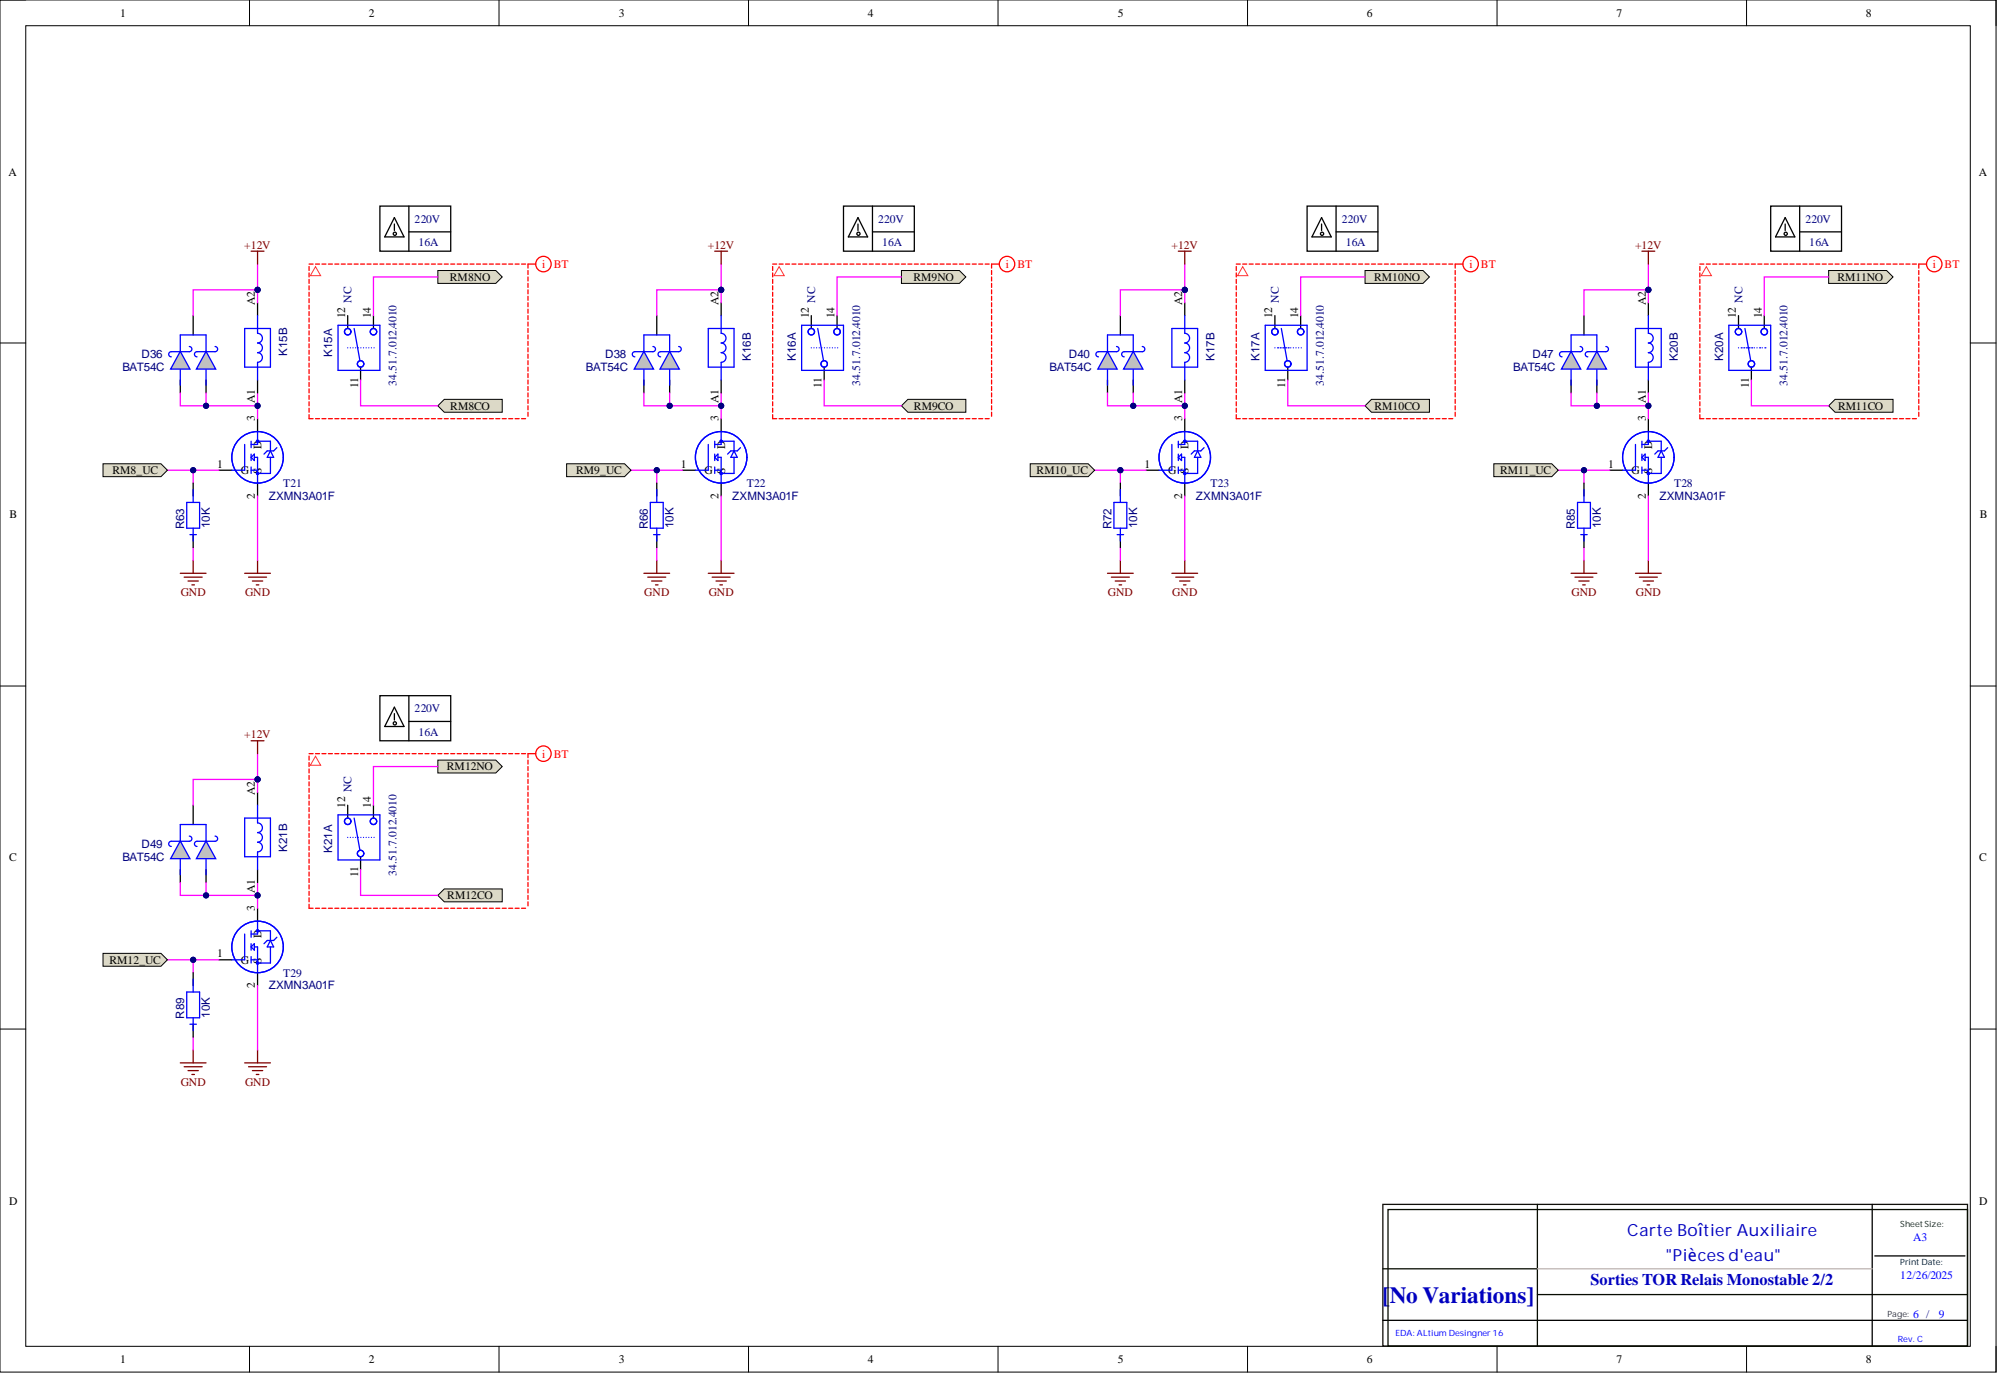
[picture p15: page 6]

Sorties TOR Relais Monostable 2/2

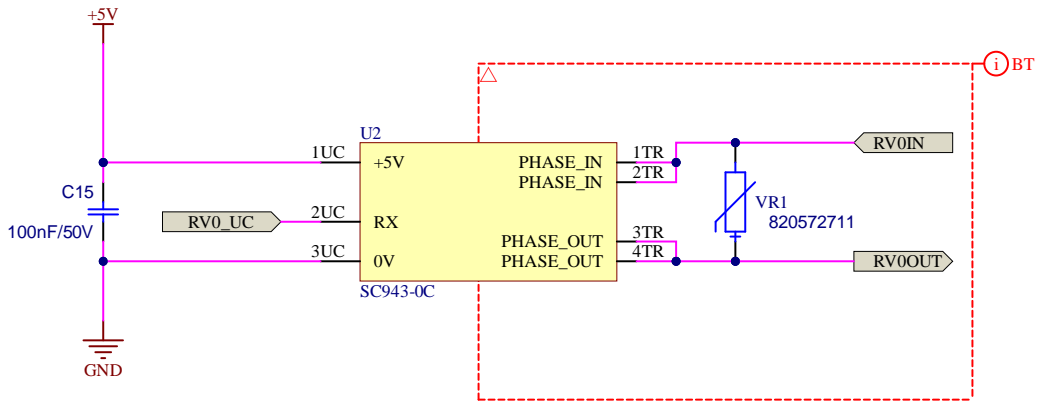
[picture p16: page 7]
t Date:

Variateu r s

Pag e : /

EDA: AL t i u m Des i n g ner | | Rev . C

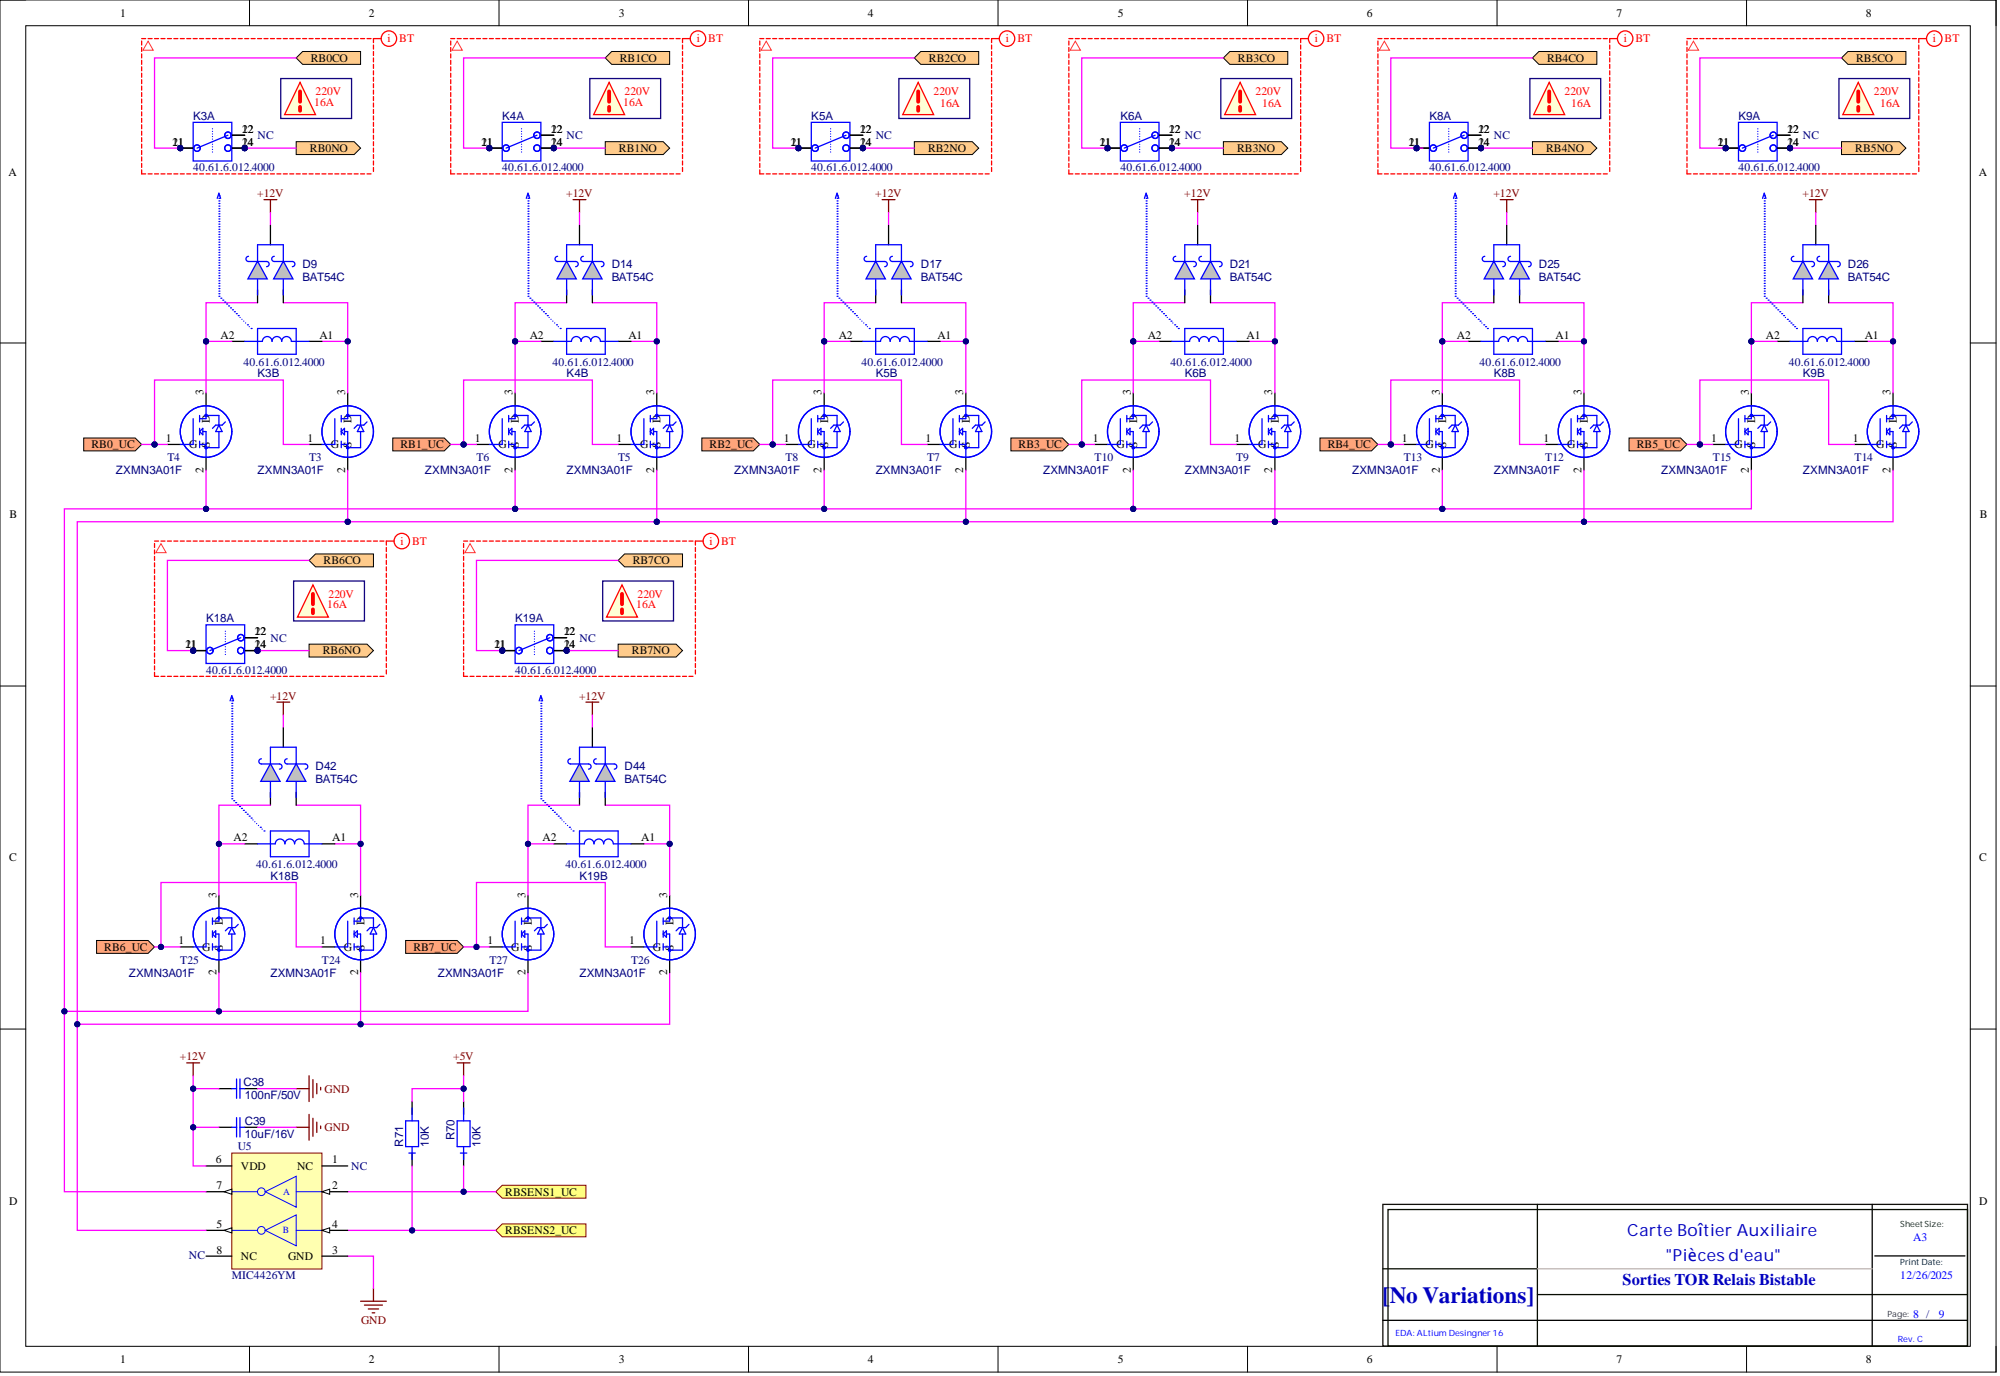
[picture p17: page 8]

Sorties TOR Relais Bistable

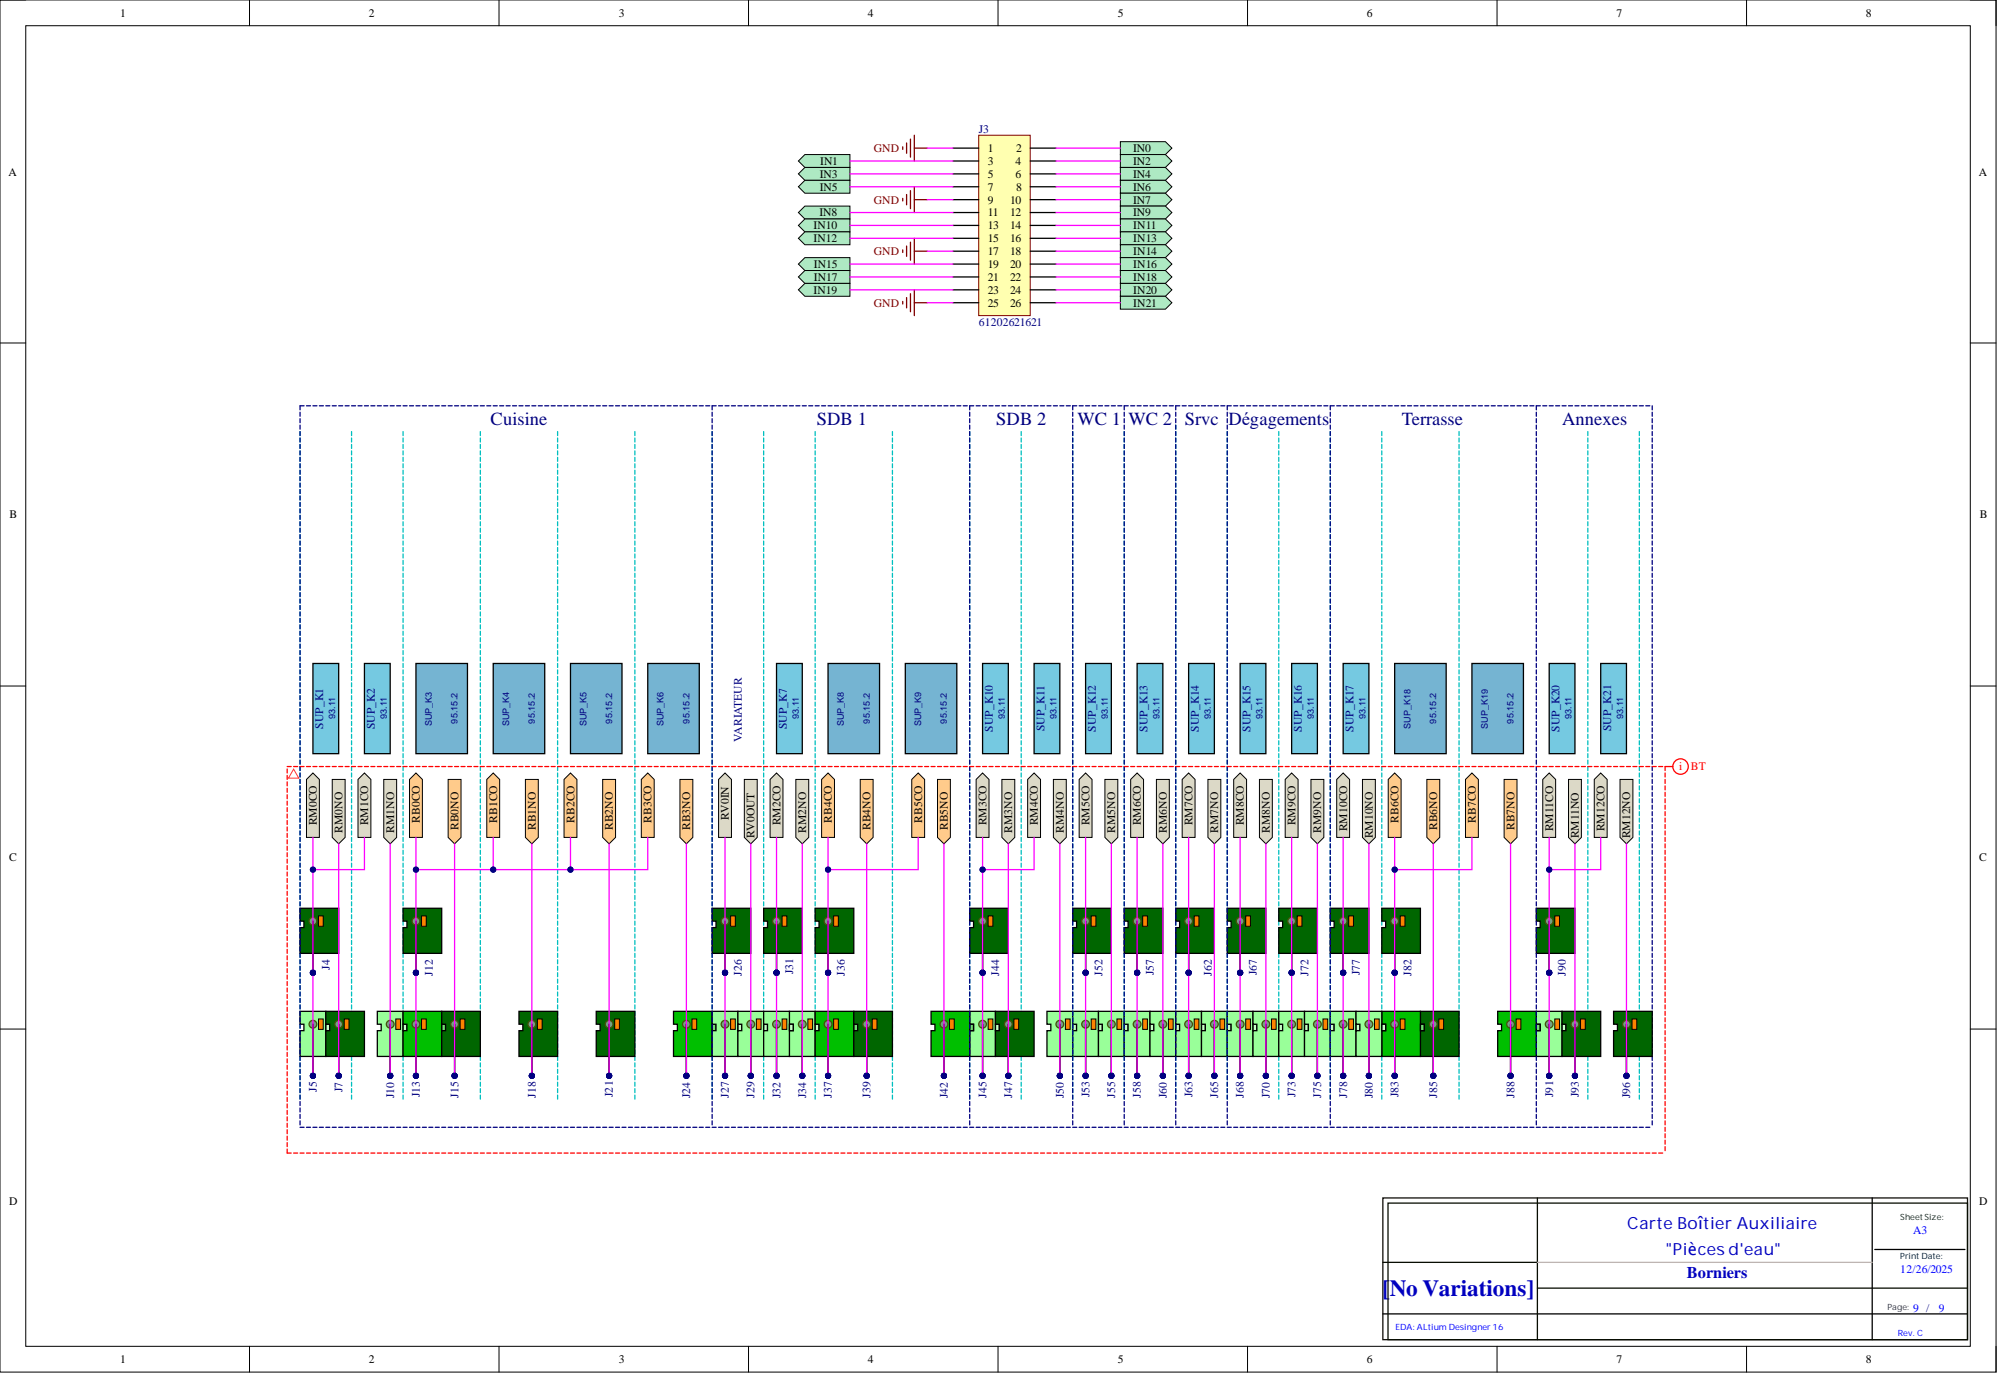
[picture p18: page 9]
