essensys-hub/essensys-board-SC941C/SC941C/Assembly/SC941C_Assembly.pdf

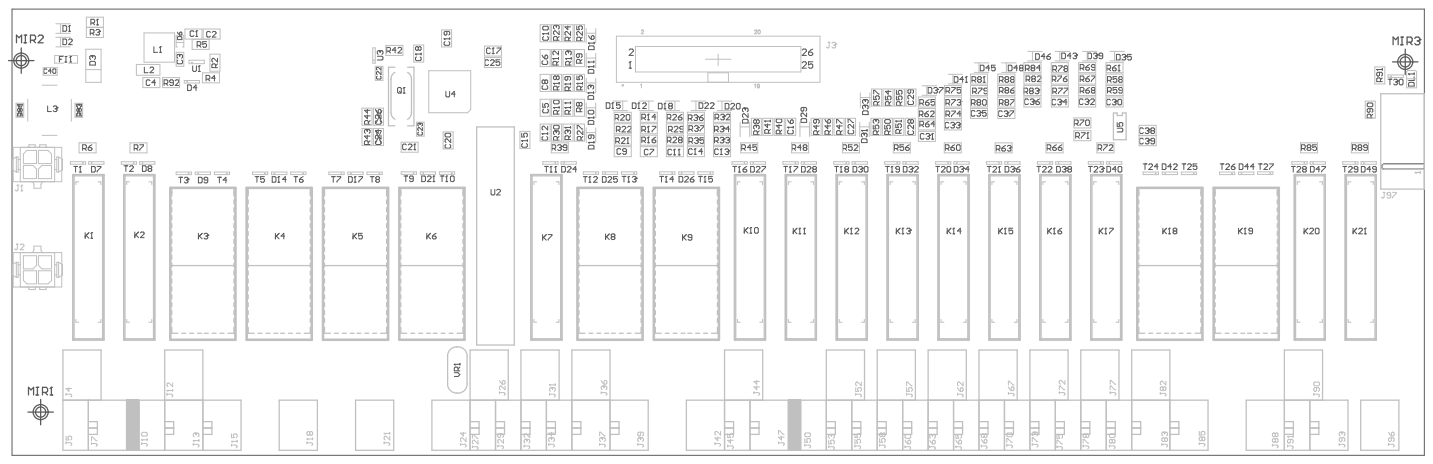
[picture p19: page 1]
