essensys-hub/essensys-board-SC941C/SC941C/Checks/SI941C_Mechanical.pdf

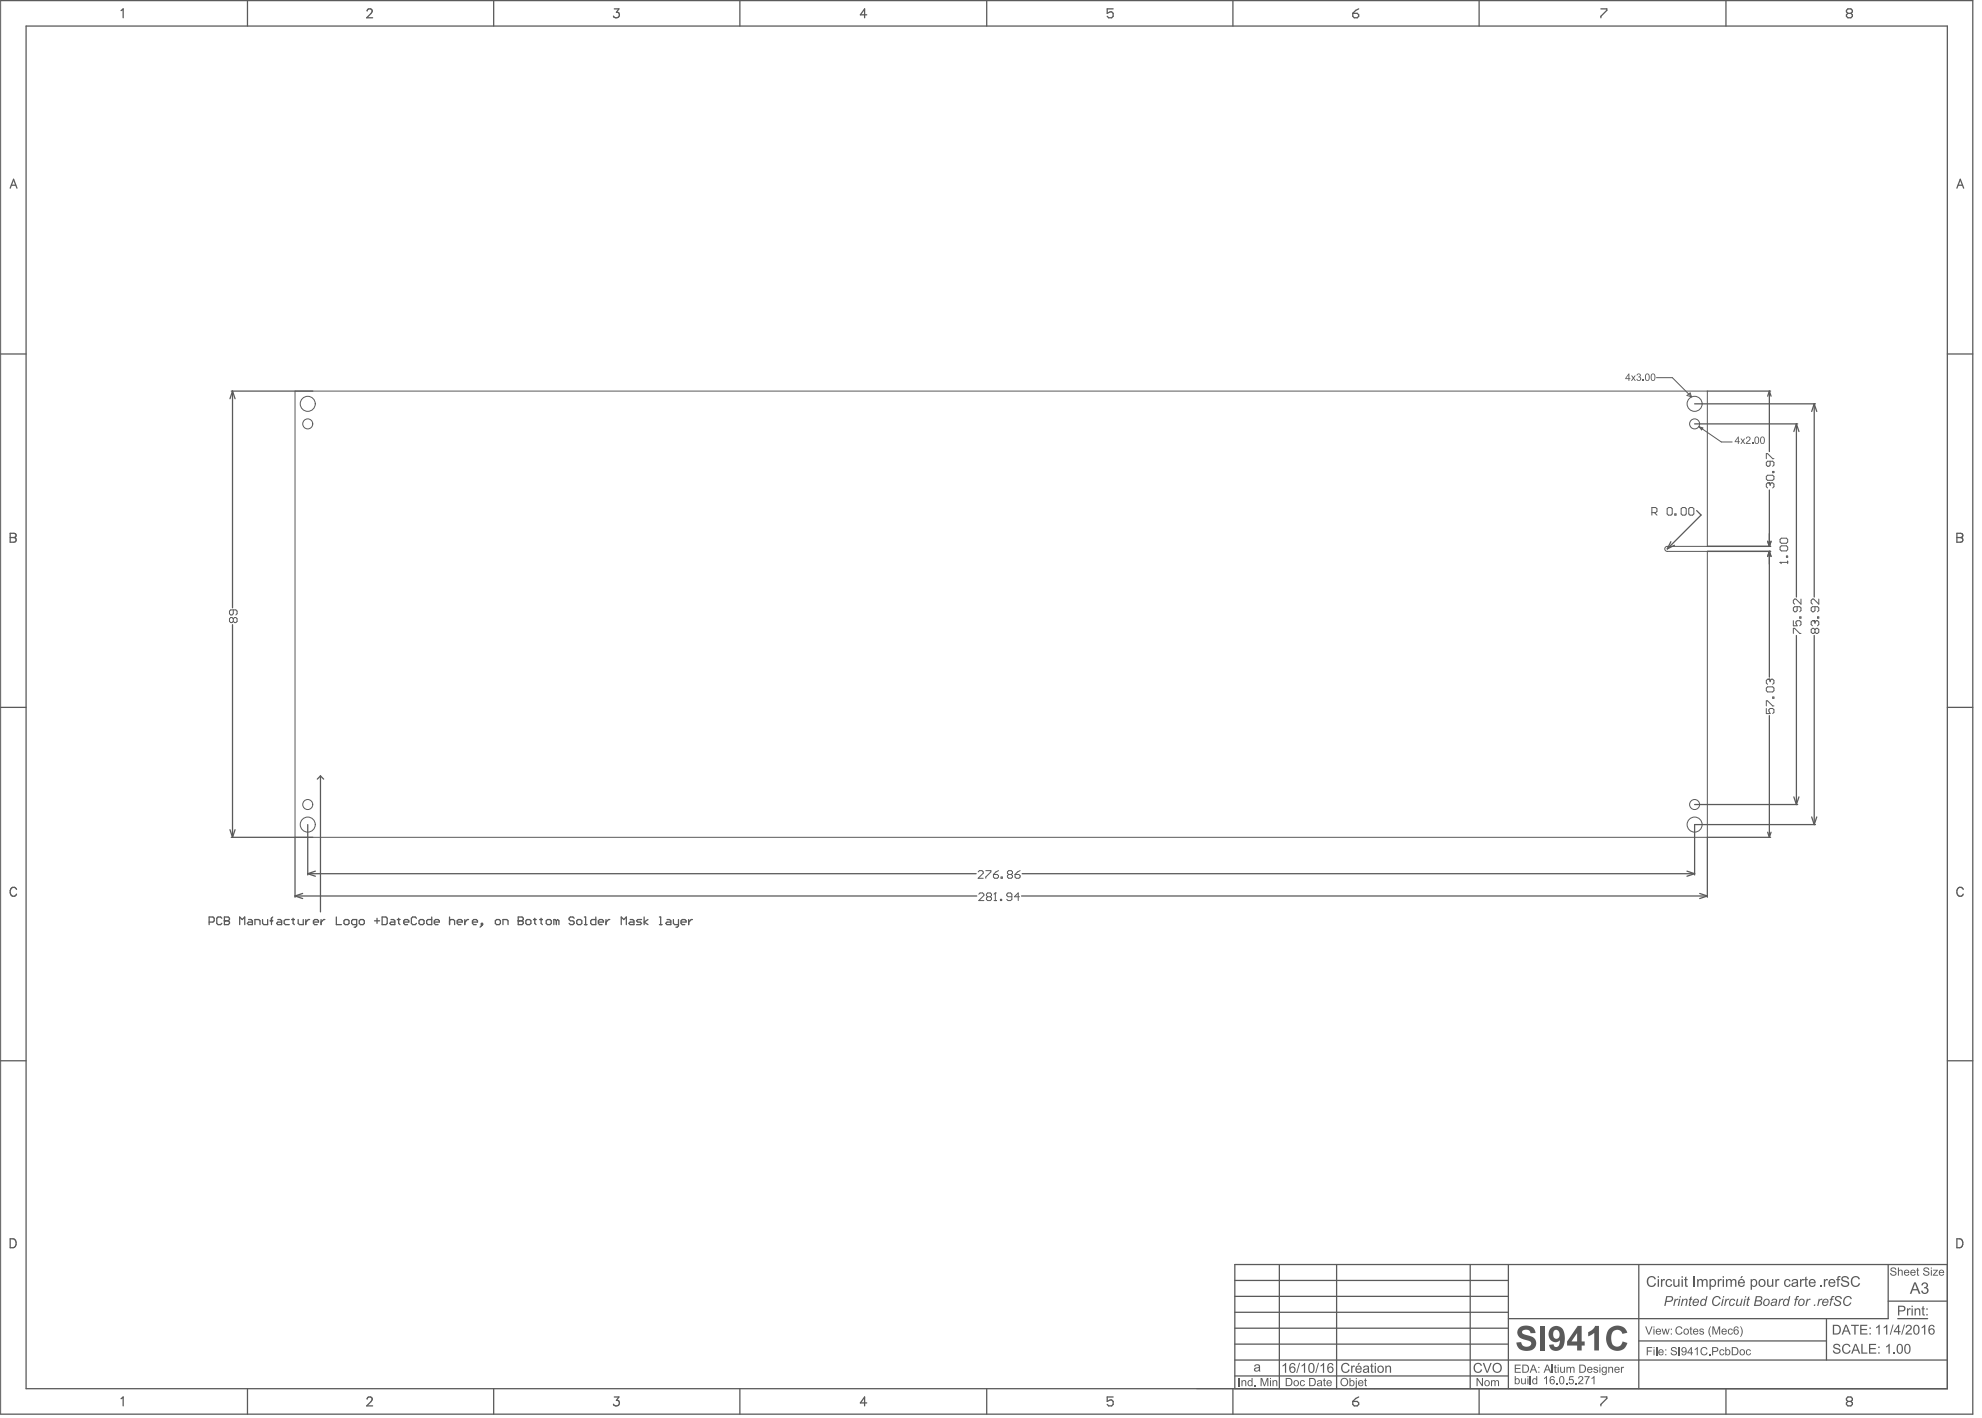
[picture p29: page 1]
