essensys-hub/essensys-board-SC941C/docs/assets/pdfs/Assembly Drawings.pdf

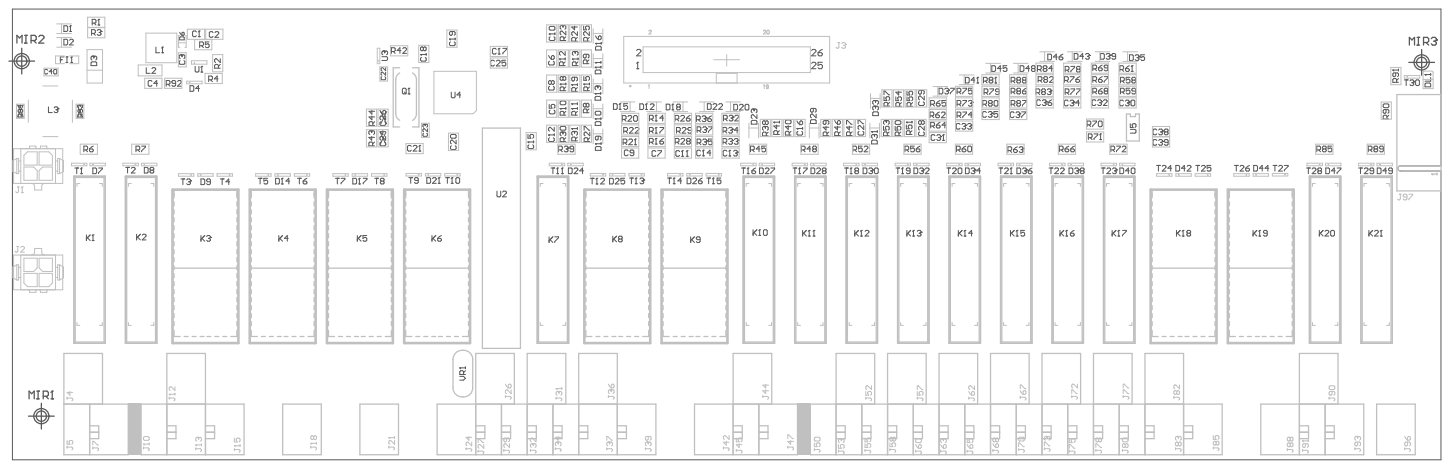
[picture p30: page 1]
