essensys-hub/essensys-board-SC941C/SC941C/Checks/SC941C_Drill.pdf

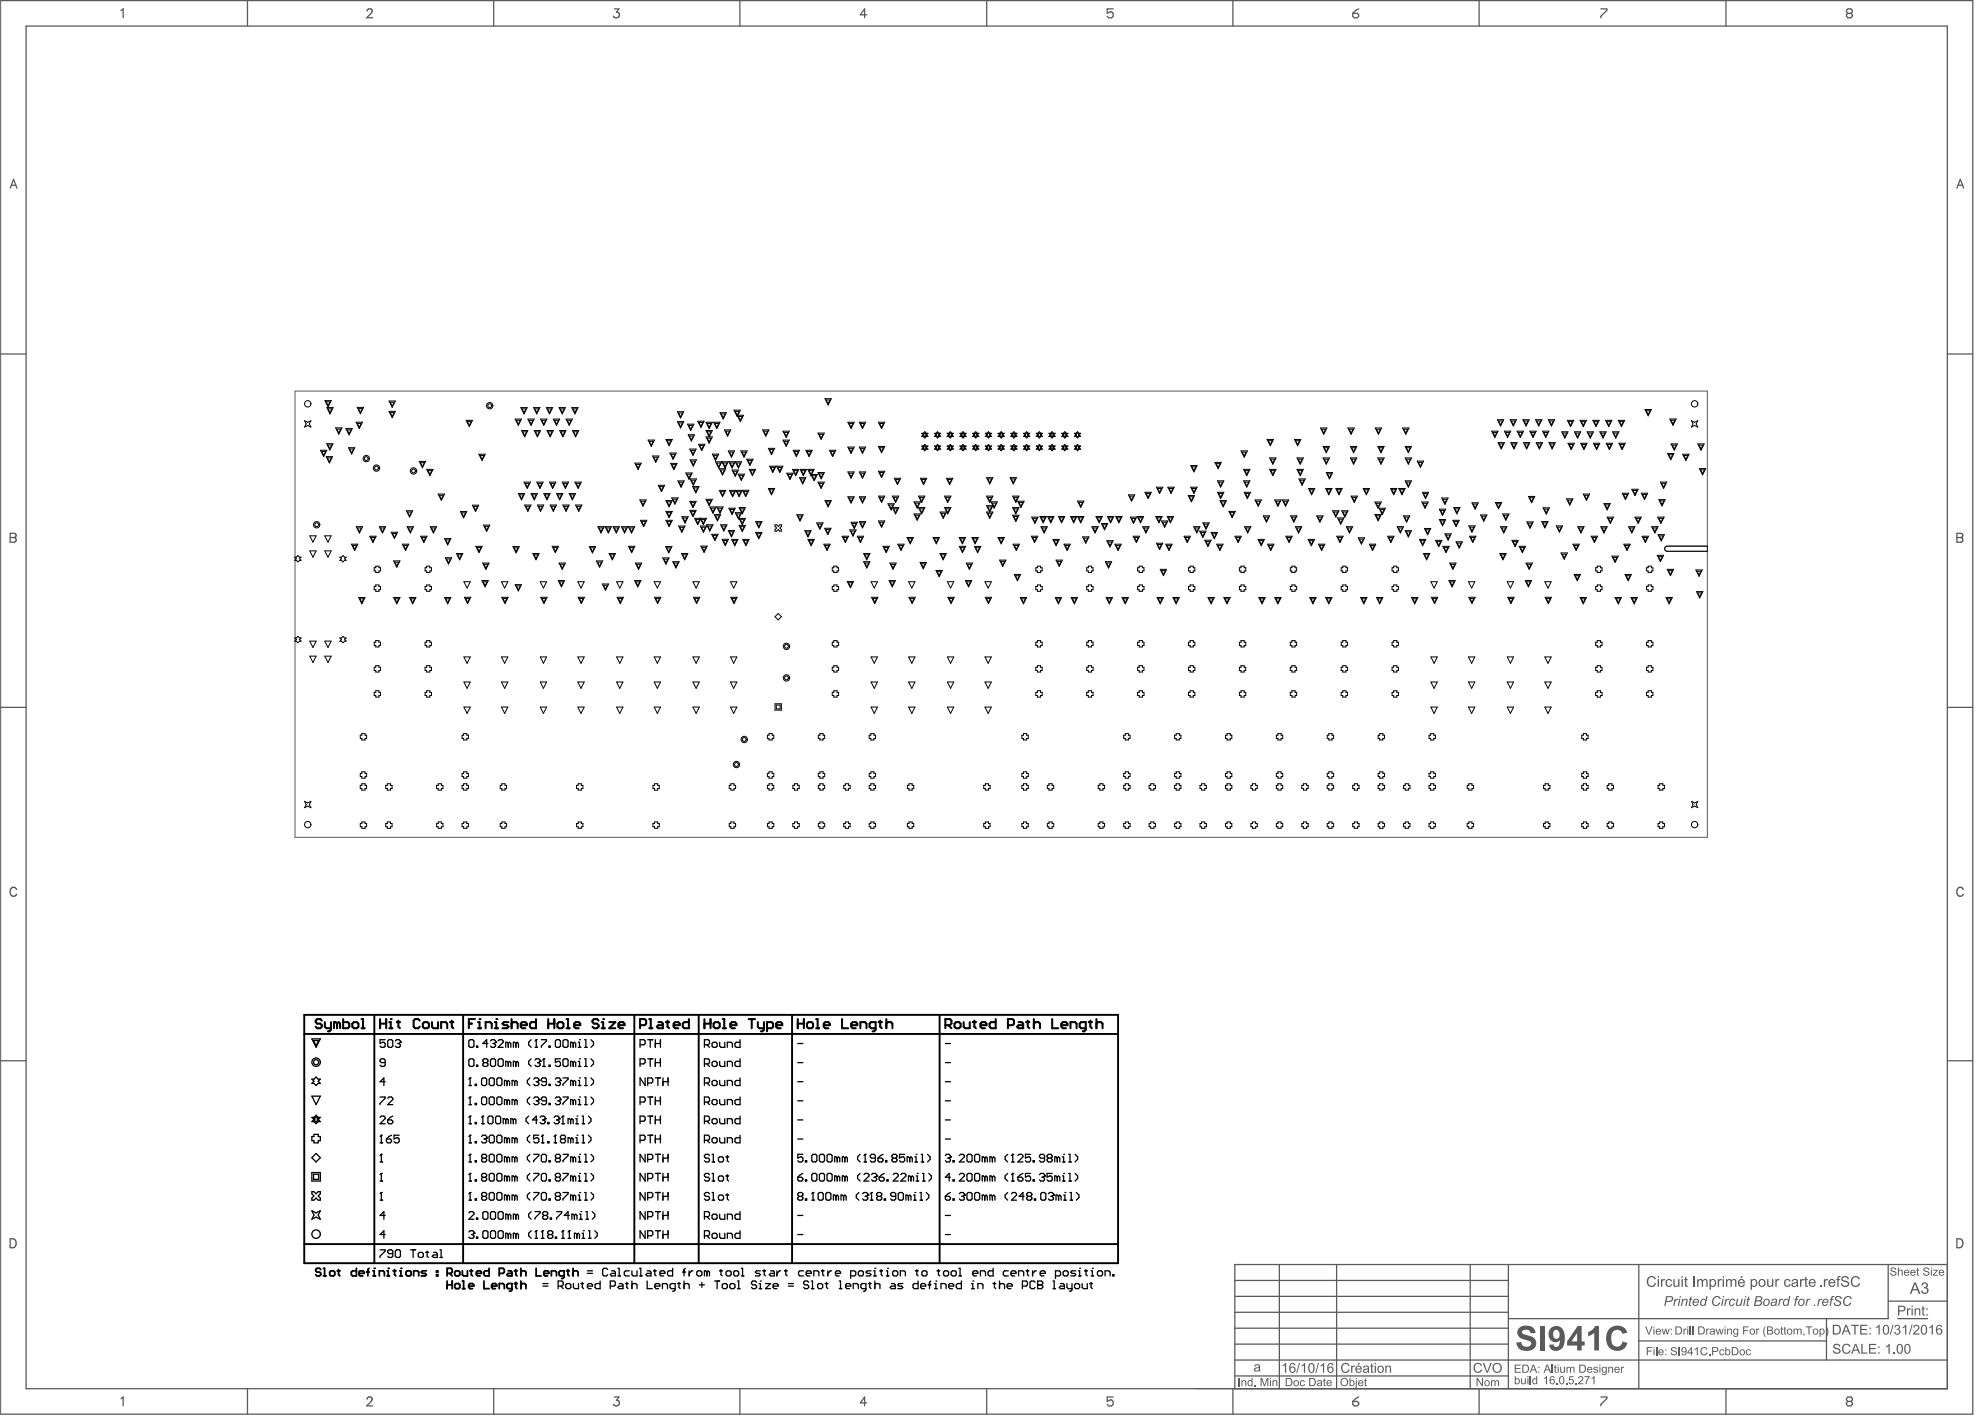
[picture p31: page 1]

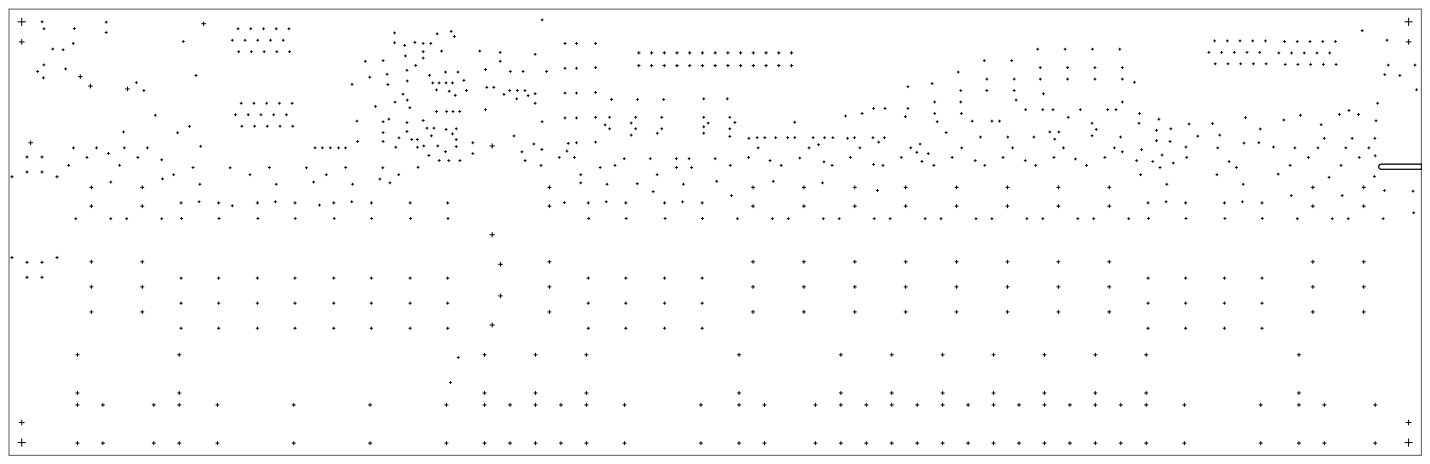
[picture p32: page 2]
