essensys-hub/essensys-board-SC941C/SC941C/Gerbers/Panel/SI941C panel drawing.pdf

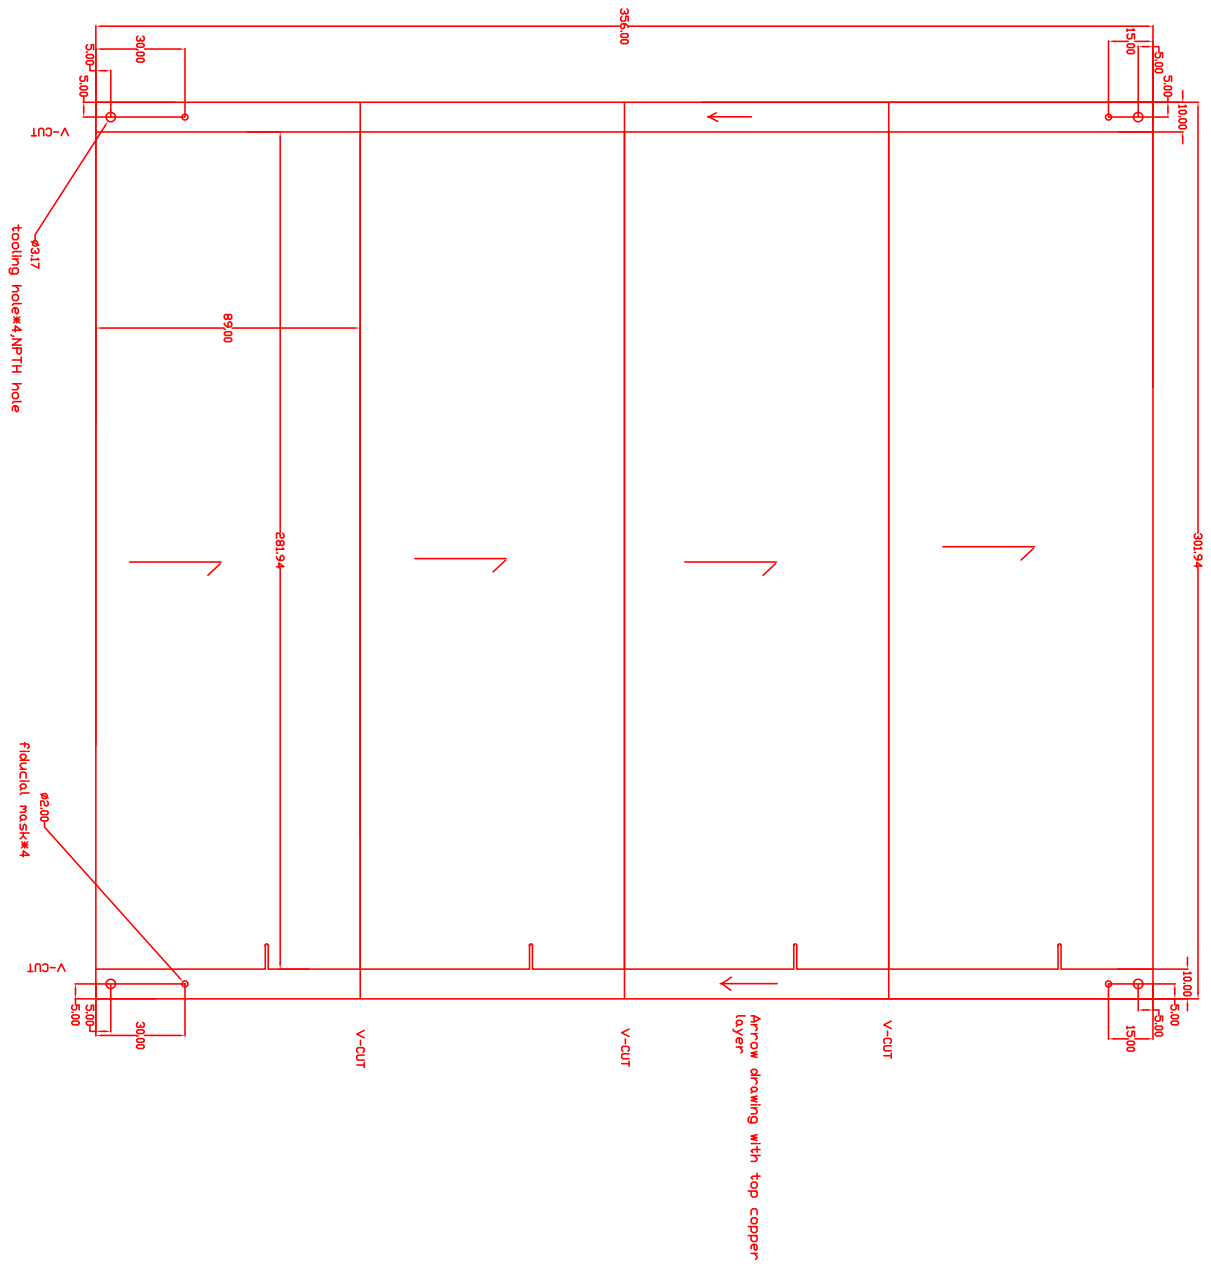
[picture p33: page 1]
