essensys-hub/essensys-board-SC941C/SC941C/Assembly/_Archives/SC941C_Schematic.pdf

a | Cr e atio n | 1 1/1 0/1 6 | CV O | CV O | NGI | NGI

Re v | De s cription | Da t e | Author | Drawn | Che c k | Approv

C a r t e B o î tie r Auxiliair e " P i è c es d ' e au" | S h e e t Size : A 3

[No Variations] | P a ge de Garde

E D A : A L tium D esin g n e r 1 6 | | R e v . C

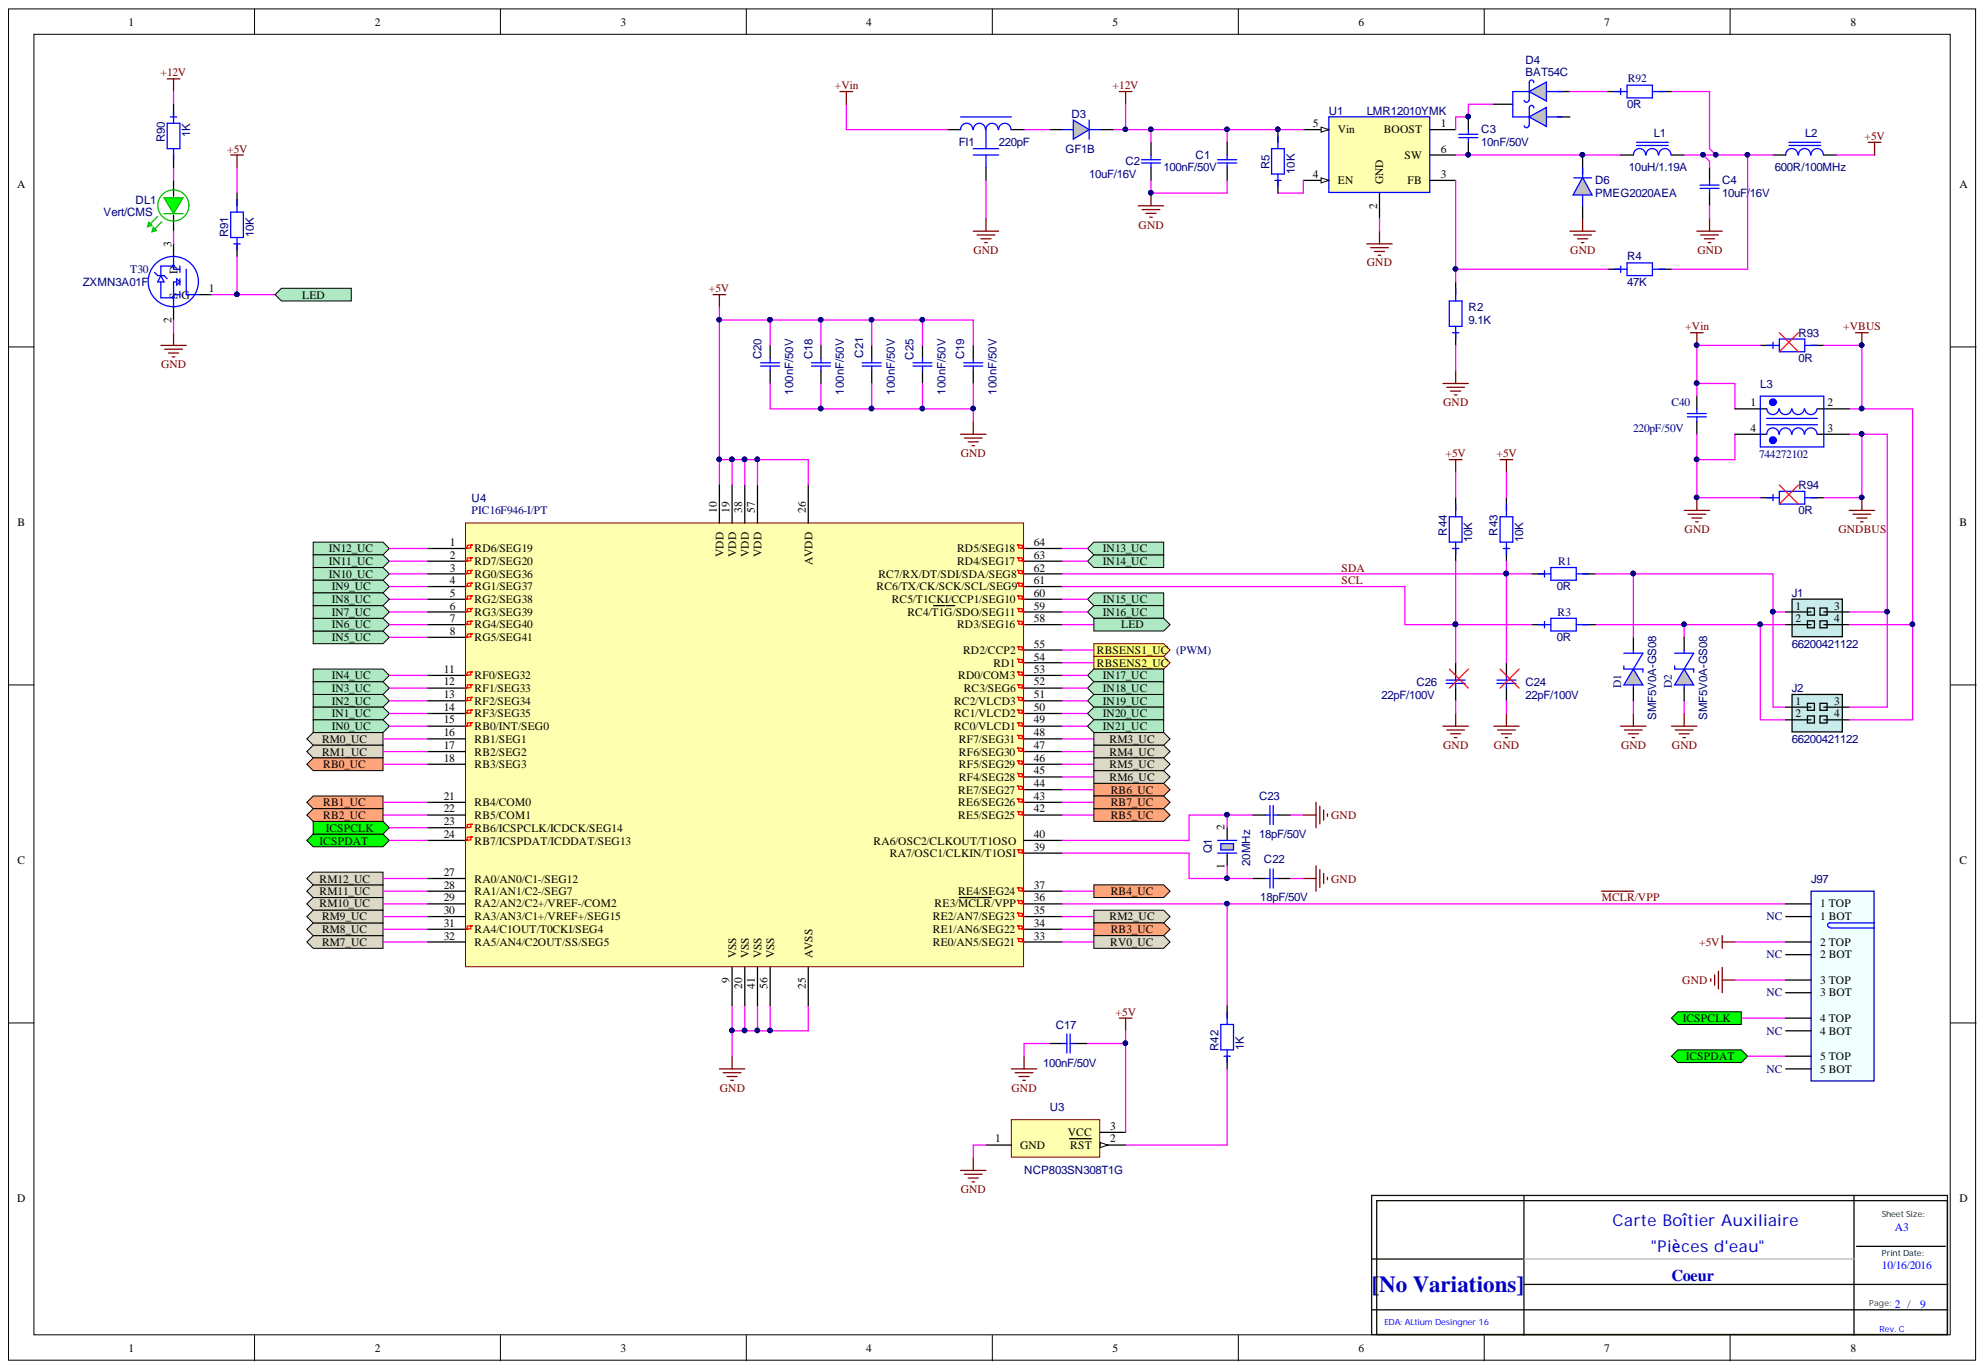
[picture p34: page 2]

L 3 | 2

[No Variations] | C oeur

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


[No Variations] | Entrées TOR 1/2

Page: 3 / 9

EDA: ALtium Desingner 16 | | Rev. C

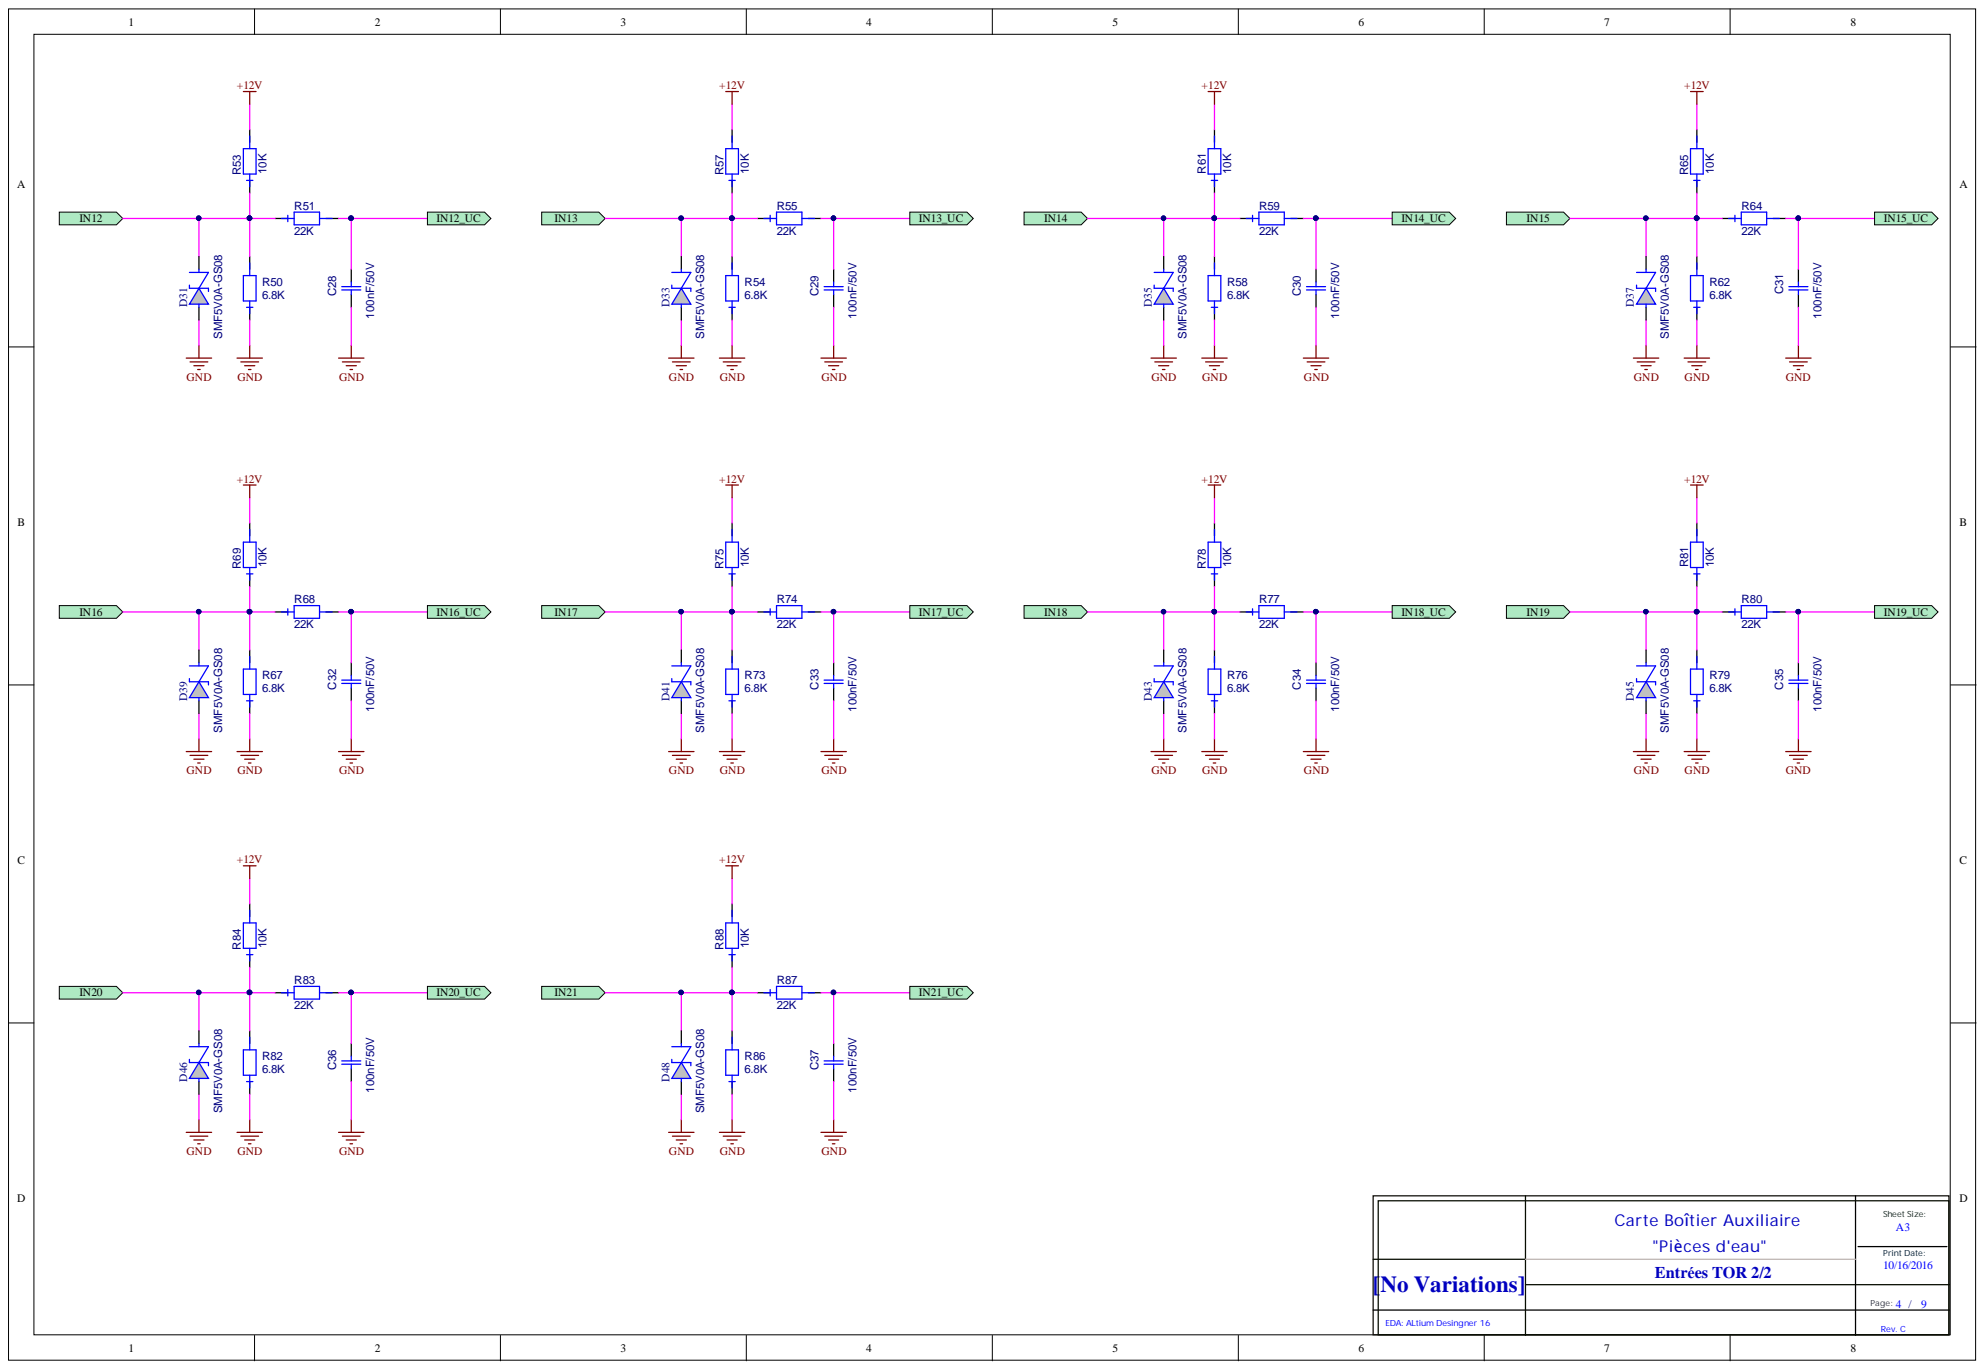
[picture p35: page 4]

[No Variations] | Entrées TOR 2/2

Page: 4 / 9

EDA: ALtium Desingner 16


[No Variations] | Sorties TOR Relais Monostable 1/2

Page: 5 / 9

EDA: ALtium Desingner 16


[No Variations] | Sorties TOR Relais Monostable 2/2

Page: 6 / 9

EDA: ALtium Desingner 16


[No Variations] | V ari ateurs

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


[No Variations] | Sorties TOR Relais Bistable

Page: 8 / 9

EDA: ALtium Desingner 16


[No Variations] | Borniers

Page: 9 / 9

EDA: ALtium Desingner 16 | | Rev. C
