essensys-hub/essensys-board-SC941C/(list of files, drawings)

Other design files:
SC941C/SC941C.PrjPcb
SC941C/SC941C_Borniers.SchDoc
SC941C/SC941C_Coeur.SchDoc
SC941C/SC941C_ETOR1.SchDoc
SC941C/SC941C_ETOR2.SchDoc
SC941C/SC941C_Sommaire.SchDoc
SC941C/SC941C_STORRB.SchDoc
SC941C/SC941C_STORRM1.SchDoc
SC941C/SC941C_STORRM2.SchDoc
SC941C/SC941C_Variateurs.SchDoc
SC941C/SDEC941-0B.SCHLIB
SC941C/SI941C.PcbLib
